kang-sw-archive/depth-cam-adv/reference/MCU/stm32f4-discovery-with-spi-pinout-wiring.png

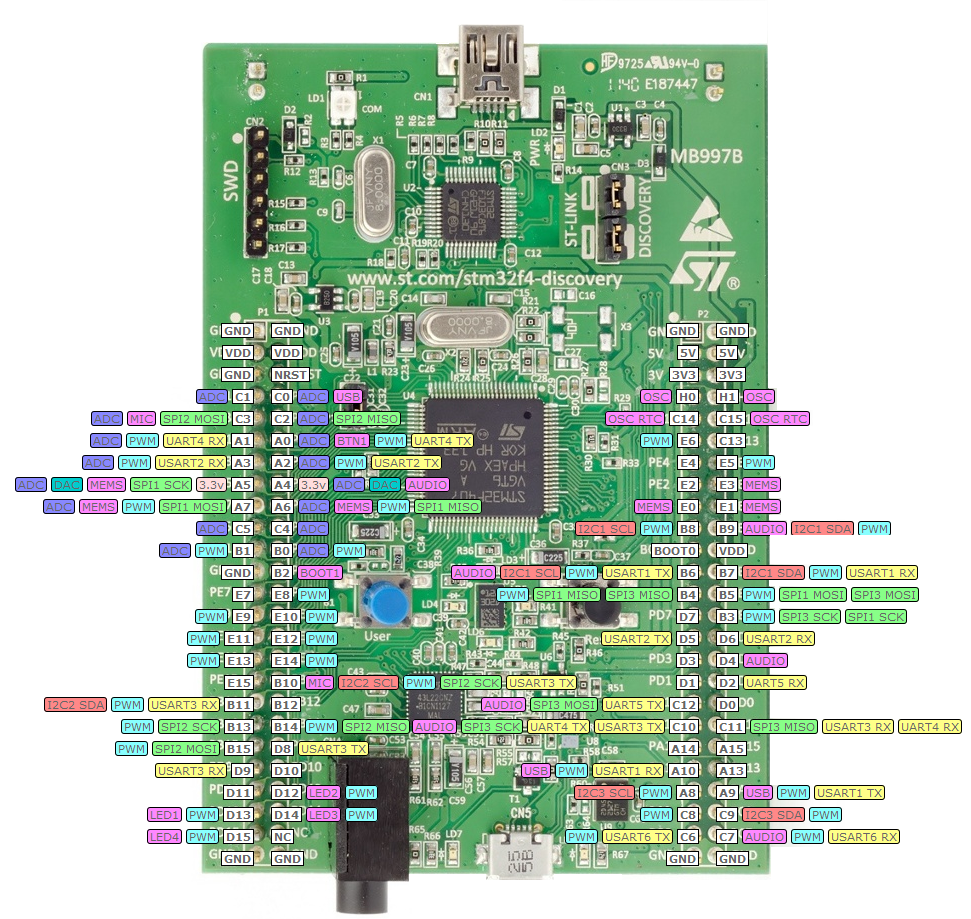
reference/MCU/stm32f4-discovery-with-spi-pinout-wiring.png
