kang-sw-archive/depth-cam-adv/samples/WIN_20200401_17_32_54_Pro.jpg

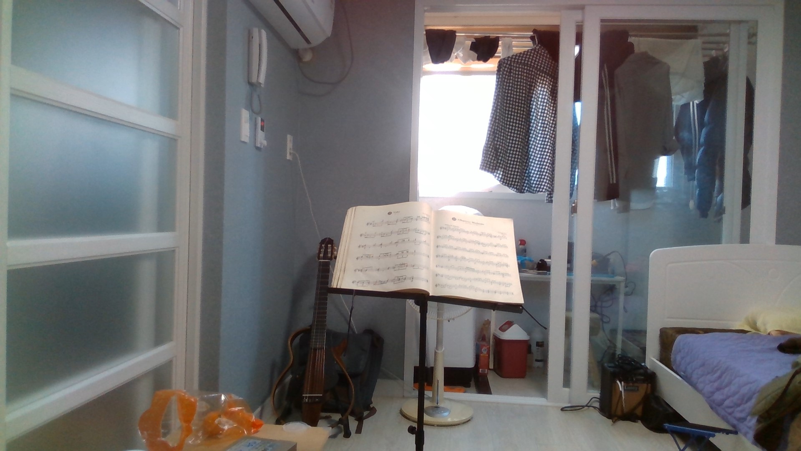
samples/WIN_20200401_17_32_54_Pro.jpg
