kang-sw-archive/depth-cam-adv/reference/Actuator/drv8825-mall.jpg

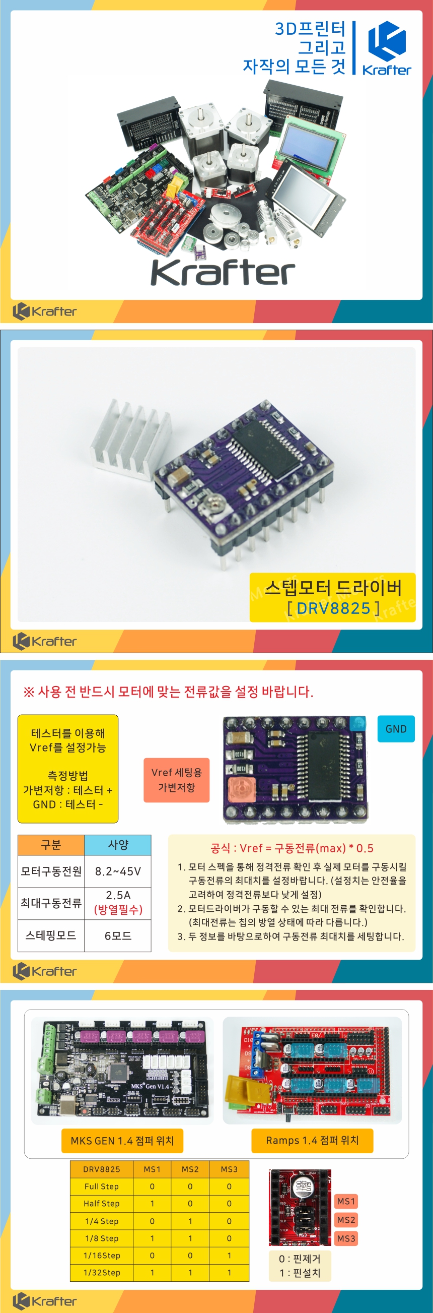
reference/Actuator/drv8825-mall.jpg
