kang-sw-archive/depth-cam-adv/reference/Actuator/DRV8825-REF.jpg

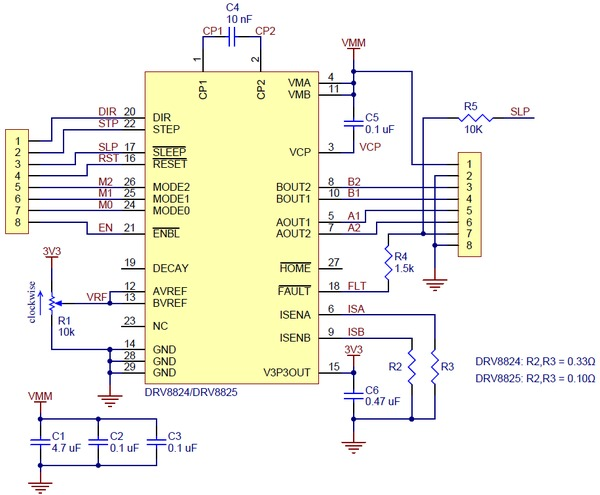
reference/Actuator/DRV8825-REF.jpg
