kang-sw-archive/depth-cam-adv/samples/case0-depth-grid.png

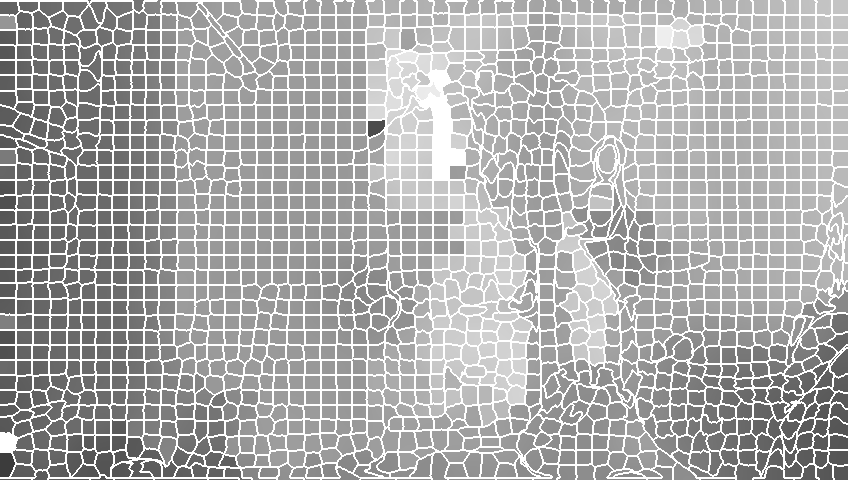
samples/case0-depth-grid.png
