kang-sw-archive/depth-cam-adv/samples/case0-rgb.png

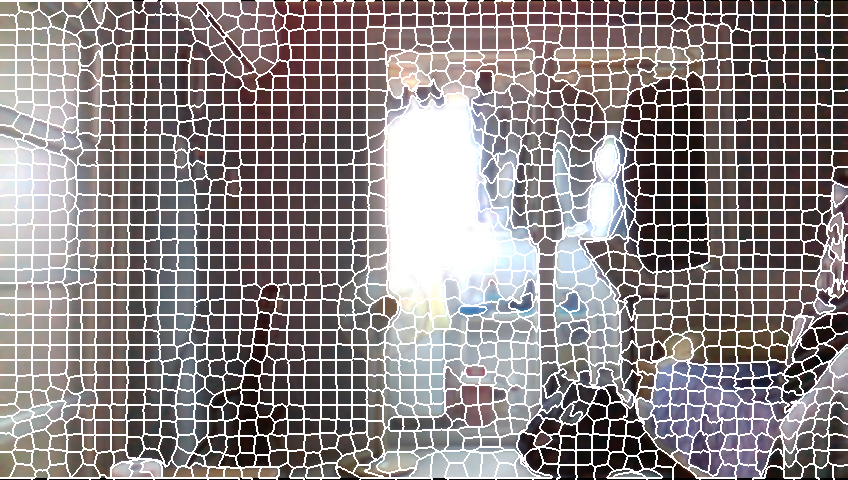
samples/case0-rgb.png
