kang-sw-archive/depth-cam-adv/samples/case1-rgb.png

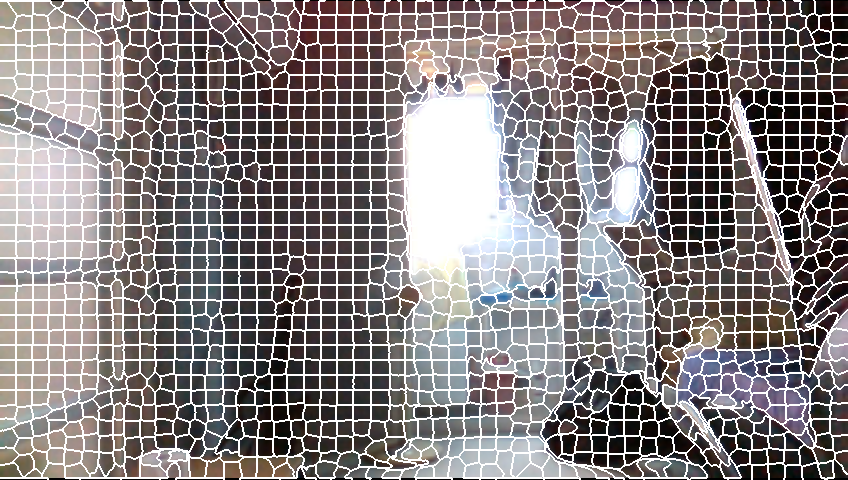
samples/case1-rgb.png
