kang-sw-archive/depth-cam-adv/samples/center_obj_book.jpg

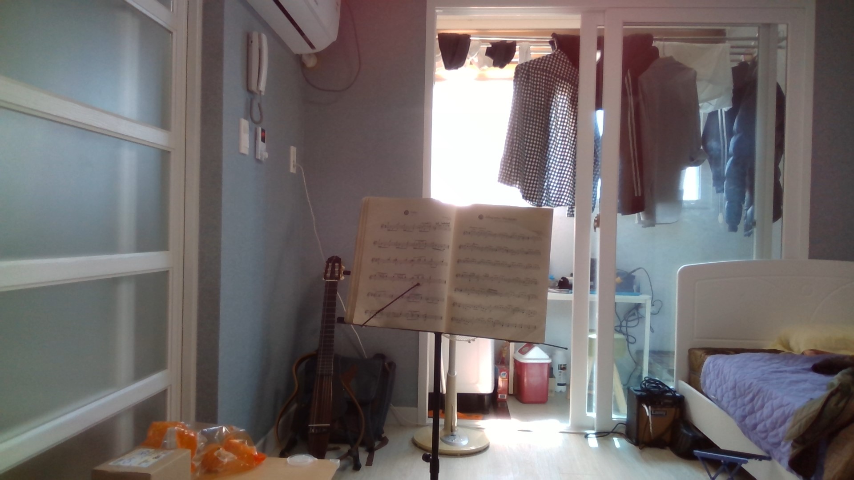
samples/center_obj_book.jpg
