kang-sw-archive/depth-cam-adv/samples/center_obj_box.jpg

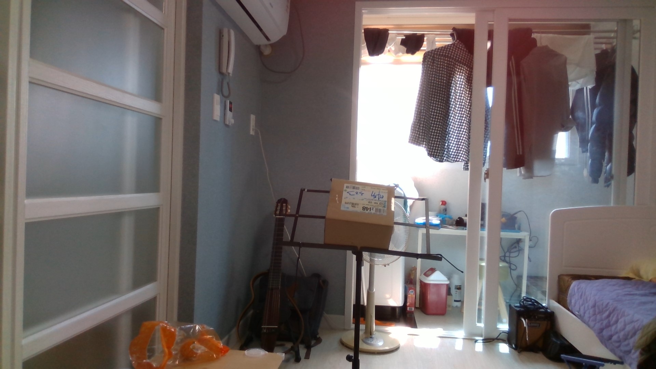
samples/center_obj_box.jpg
