kang-sw-archive/depth-cam-adv/samples/img.png

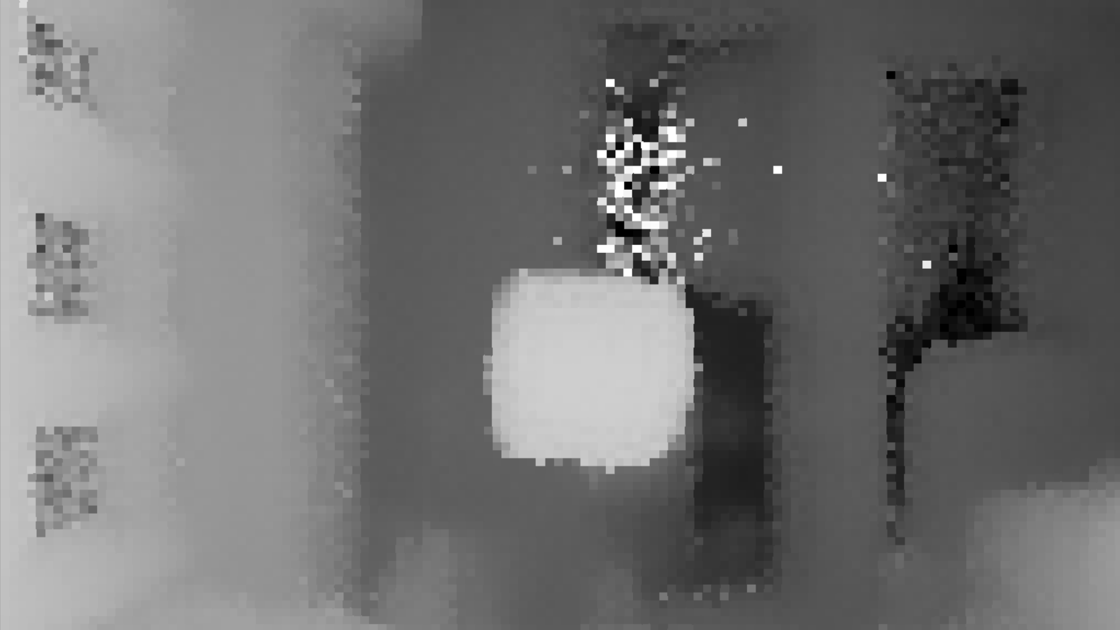
samples/img.png
