kang-sw-archive/depth-cam-adv/samples/rgb-2.png

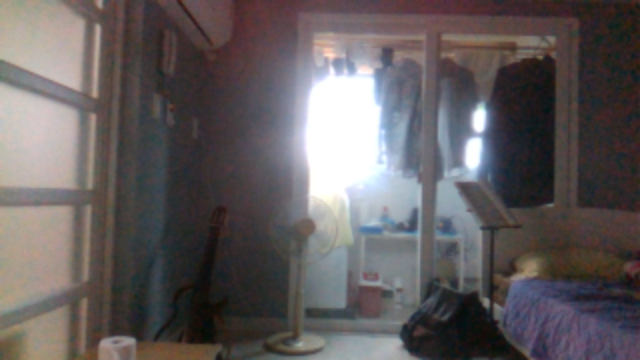
samples/rgb-2.png
