kang-sw-archive/depth-cam-adv/samples/vfov38-depth-9600smpl.png

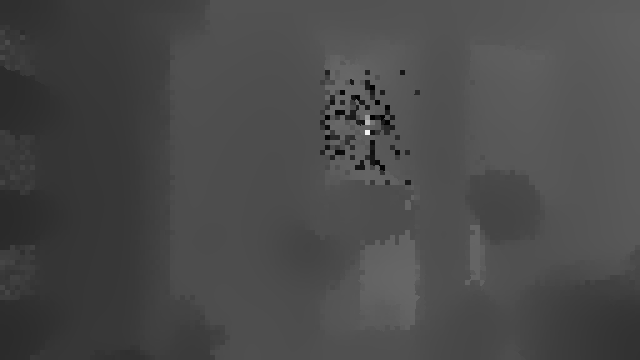
samples/vfov38-depth-9600smpl.png
