kang-sw-archive/depth-cam-adv/samples/vfov43-depth-9600pcs-2.png

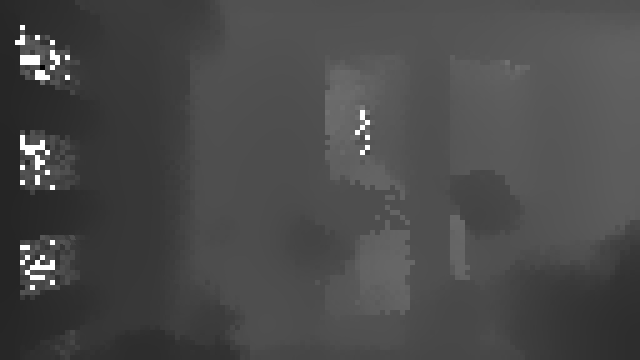
samples/vfov43-depth-9600pcs-2.png
