kang-sw-archive/depth-cam-adv/samples/vfov43-depth-9600smpl.png

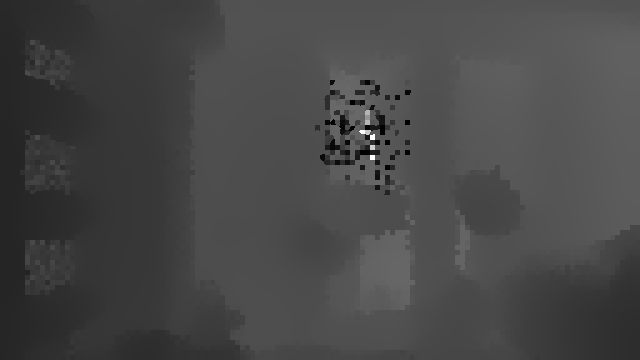
samples/vfov43-depth-9600smpl.png
