kang-sw-archive/depth-cam-adv/samples/vfov44-depth-6600pcs.png

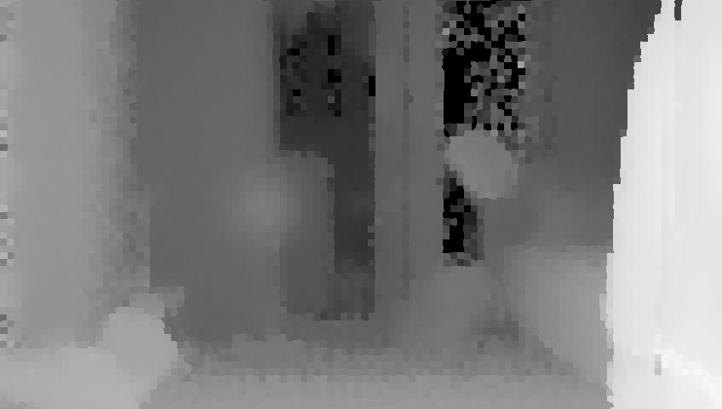
samples/vfov44-depth-6600pcs.png
