kang-sw-archive/depth-cam-adv/projects/tof-depth-map-gen-revision/TODO.md

# TODO

## Features (Lower is higher demand)
1. USB communication
   1. Data tranceiver protocol
2. PC driver application base
   1. Virtual COM Port detection
   2. Data transceiver protocol
   3. Logging / data flow watcher
3. ToF sensor driver
   1. ARGUS API hardware layer
      1. DMA SPI
      2. Timer
4. Motor interface
5. Ethernet module driver

## Done
