kang-sw-archive/depth-cam-adv/schematics/ARCHIVE/MEASURE_IF-v1.0.1/AFBR-S50_LEGACY_ART.pdf

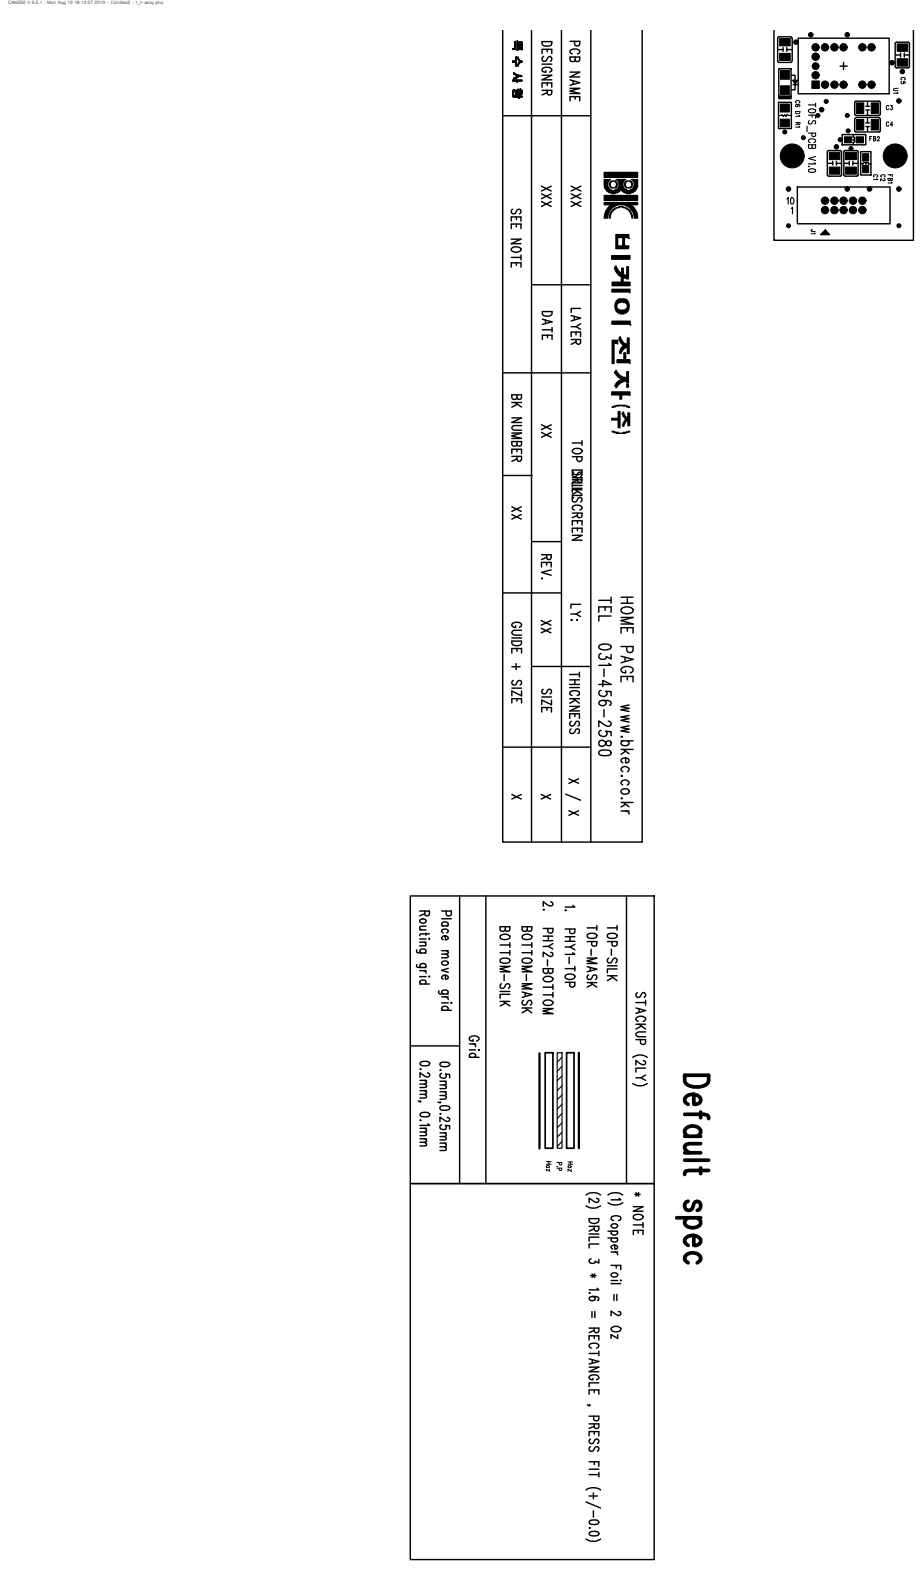
[picture p18: page 1]

CAM350 V 9.5.1 : Mon Aug 19 18:14:07 2019 - (Untitled) : 1_t-assy.pho

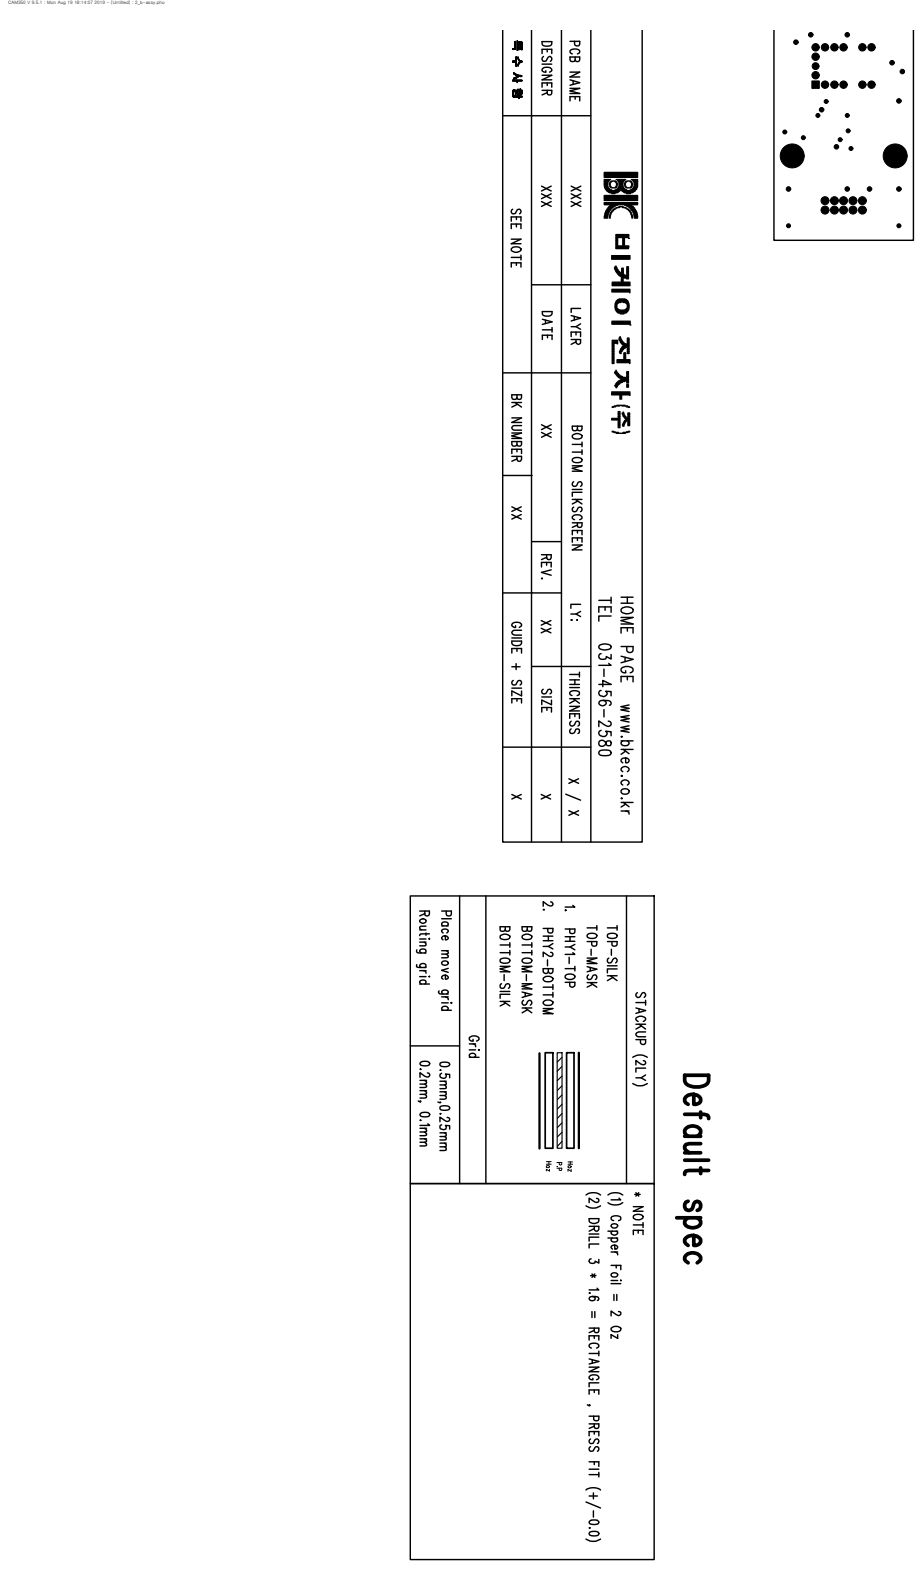
[picture p19: page 2]

CAM350 V 9.5.1 : Mon Aug 19 18:14:07 2019 - (Untitled) : 2_b-assy.pho

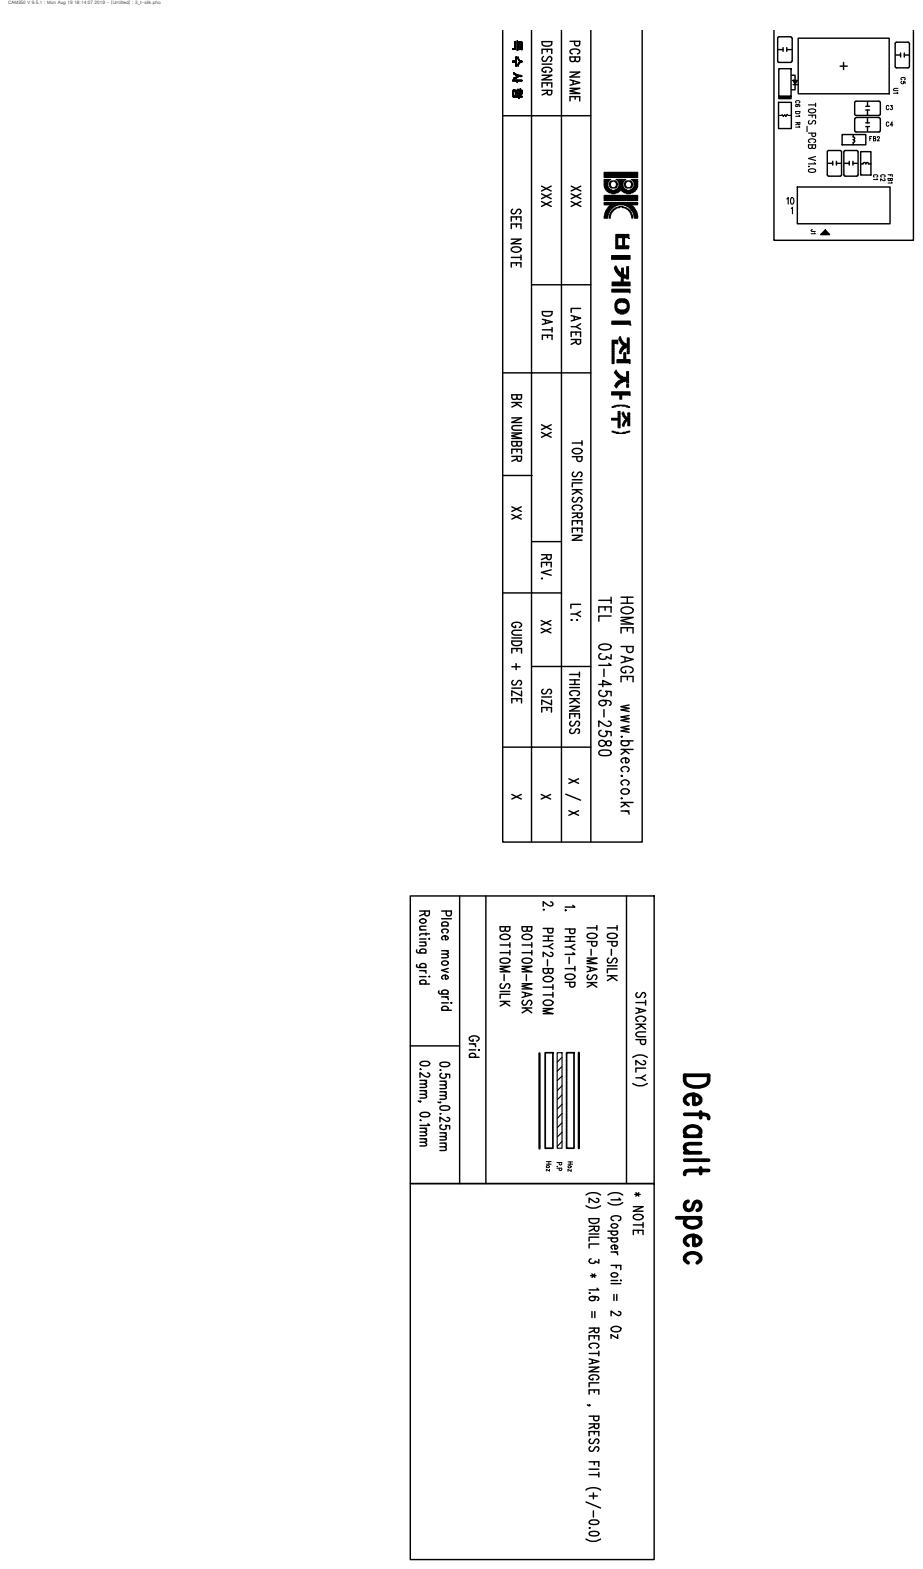
[picture p20: page 3]

CAM350 V 9.5.1 : Mon Aug 19 18:14:07 2019 - (Untitled) : 3_t-silk.pho

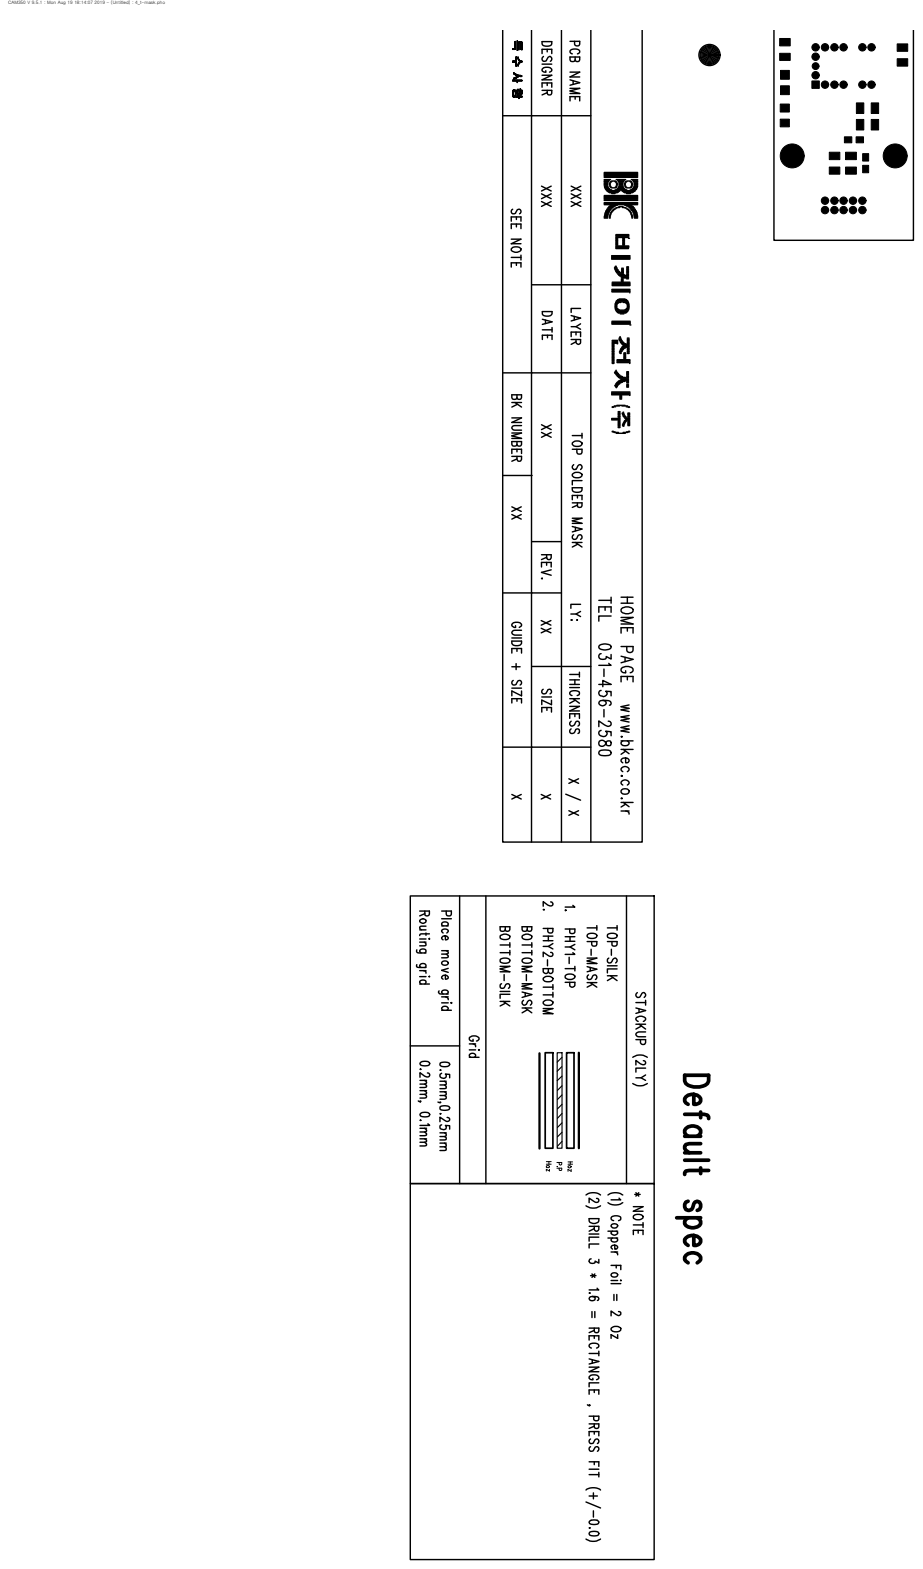
[picture p21: page 4]

CAM350 V 9.5.1 : Mon Aug 19 18:14:07 2019 - (Untitled) : 4_t-mask.pho

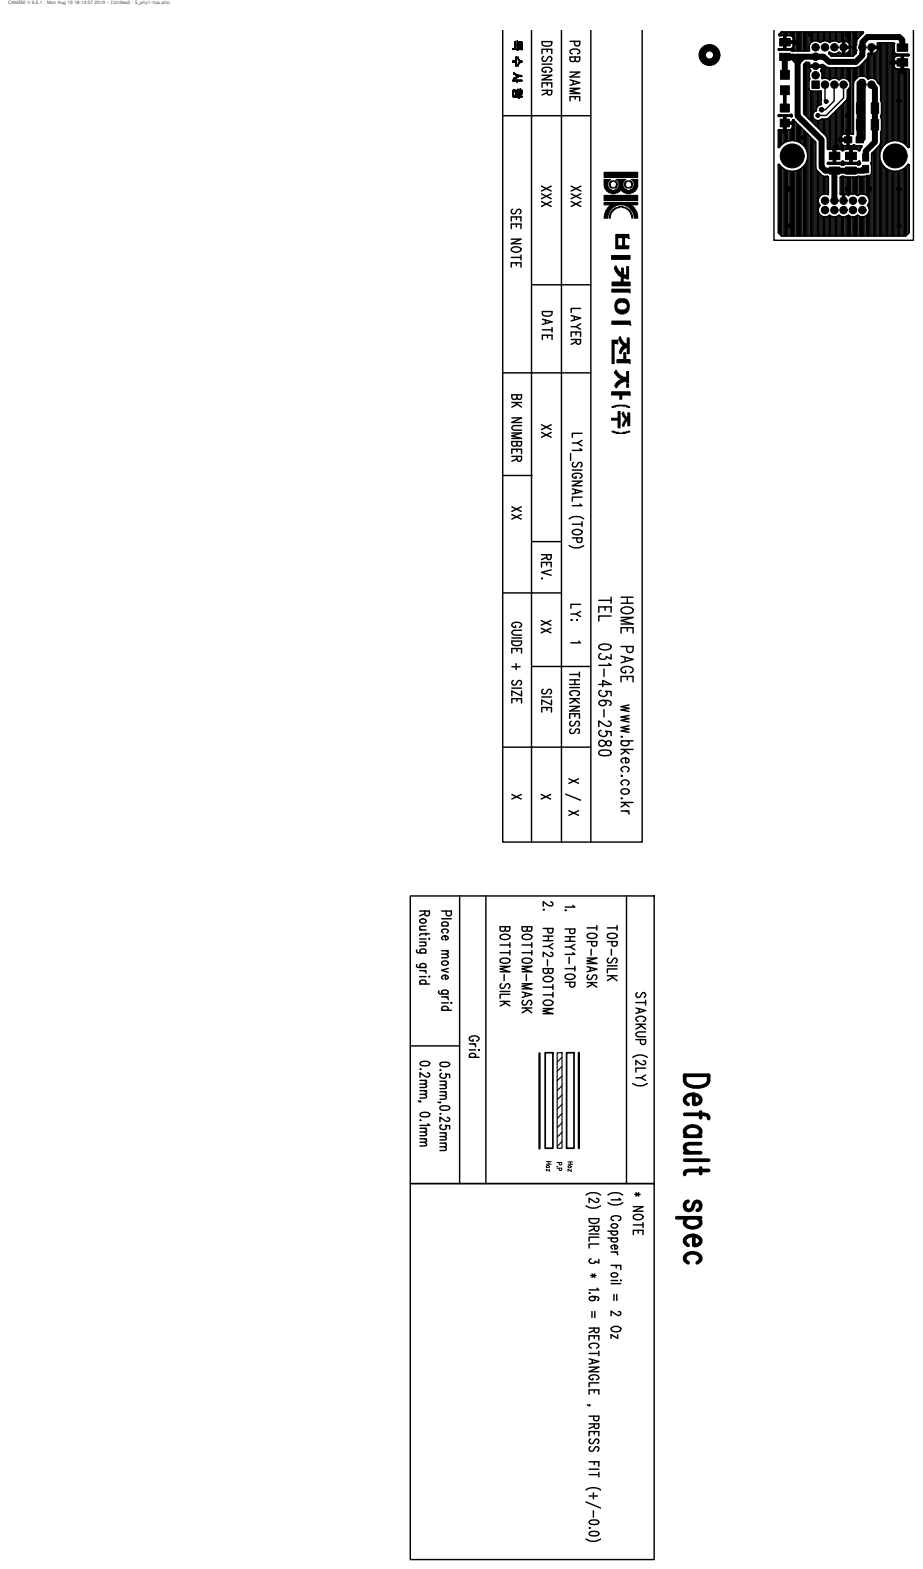
[picture p22: page 5]

CAM350 V 9.5.1 : Mon Aug 19 18:14:07 2019 - (Untitled) : 5_phy1-top.pho

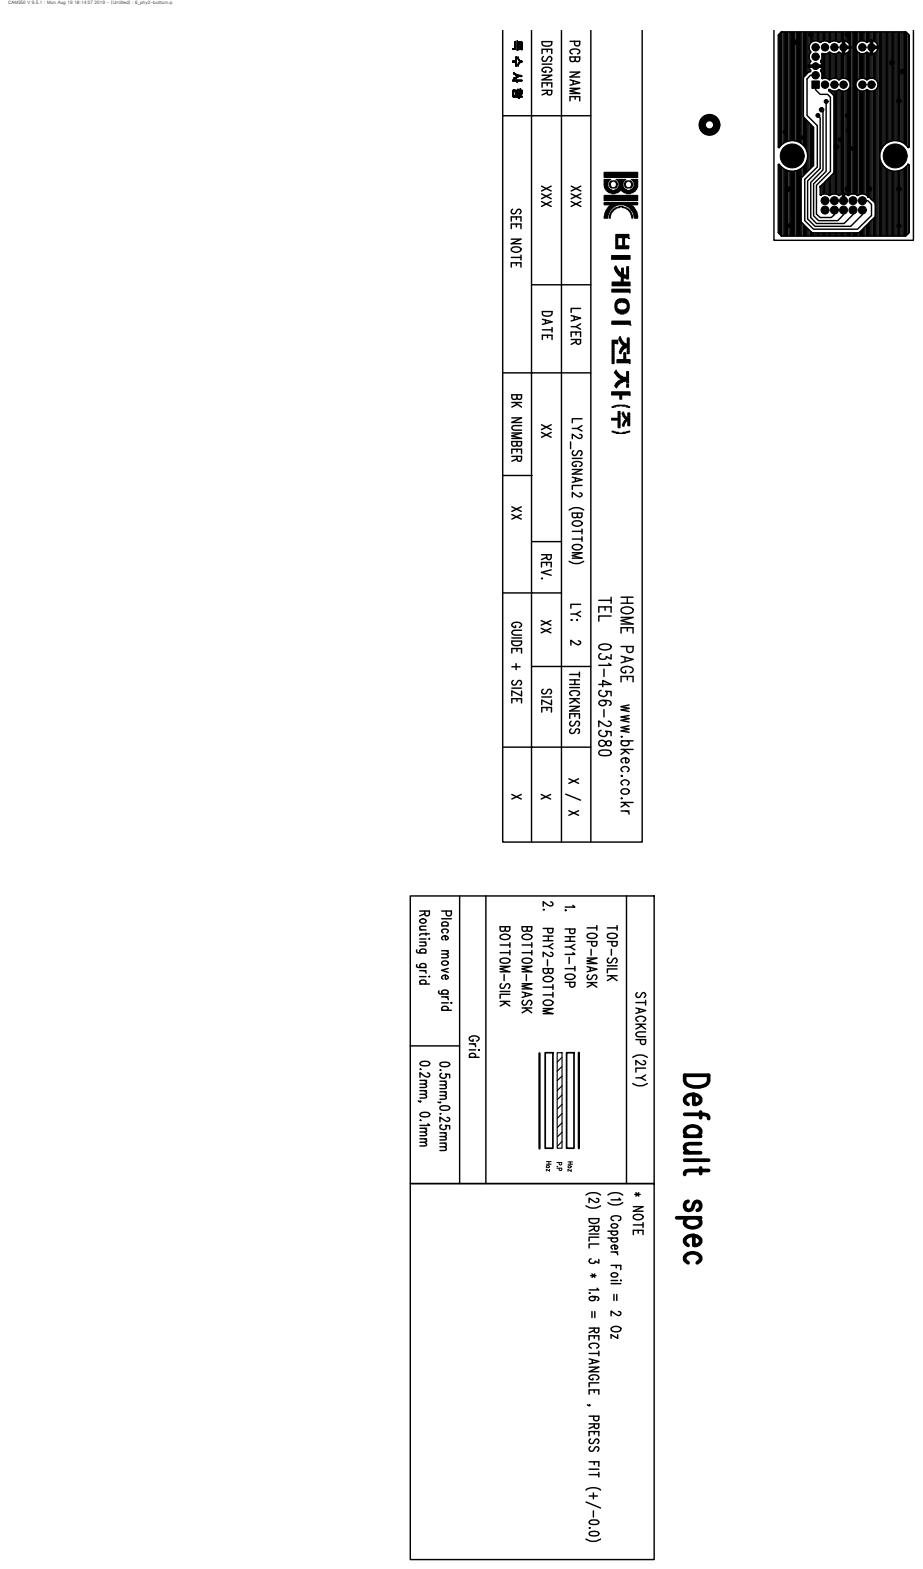
[picture p23: page 6]

CAM350 V 9.5.1 : Mon Aug 19 18:14:07 2019 - (Untitled) : 6_phy2-bottom.p

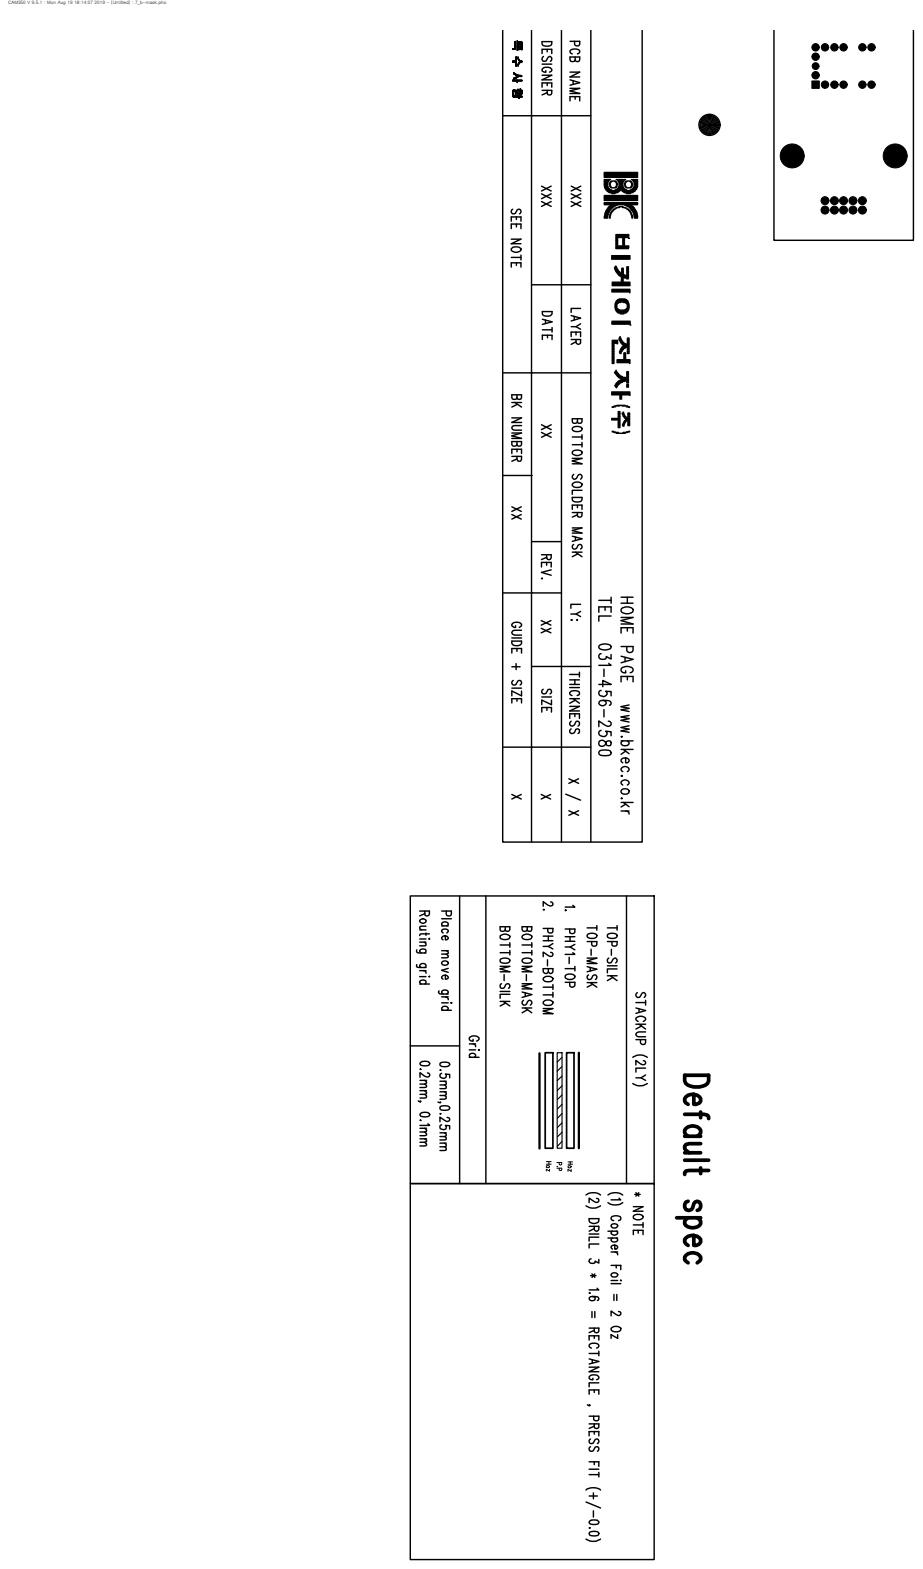
[picture p24: page 7]

CAM350 V 9.5.1 : Mon Aug 19 18:14:07 2019 - (Untitled) : 7_b-mask.pho

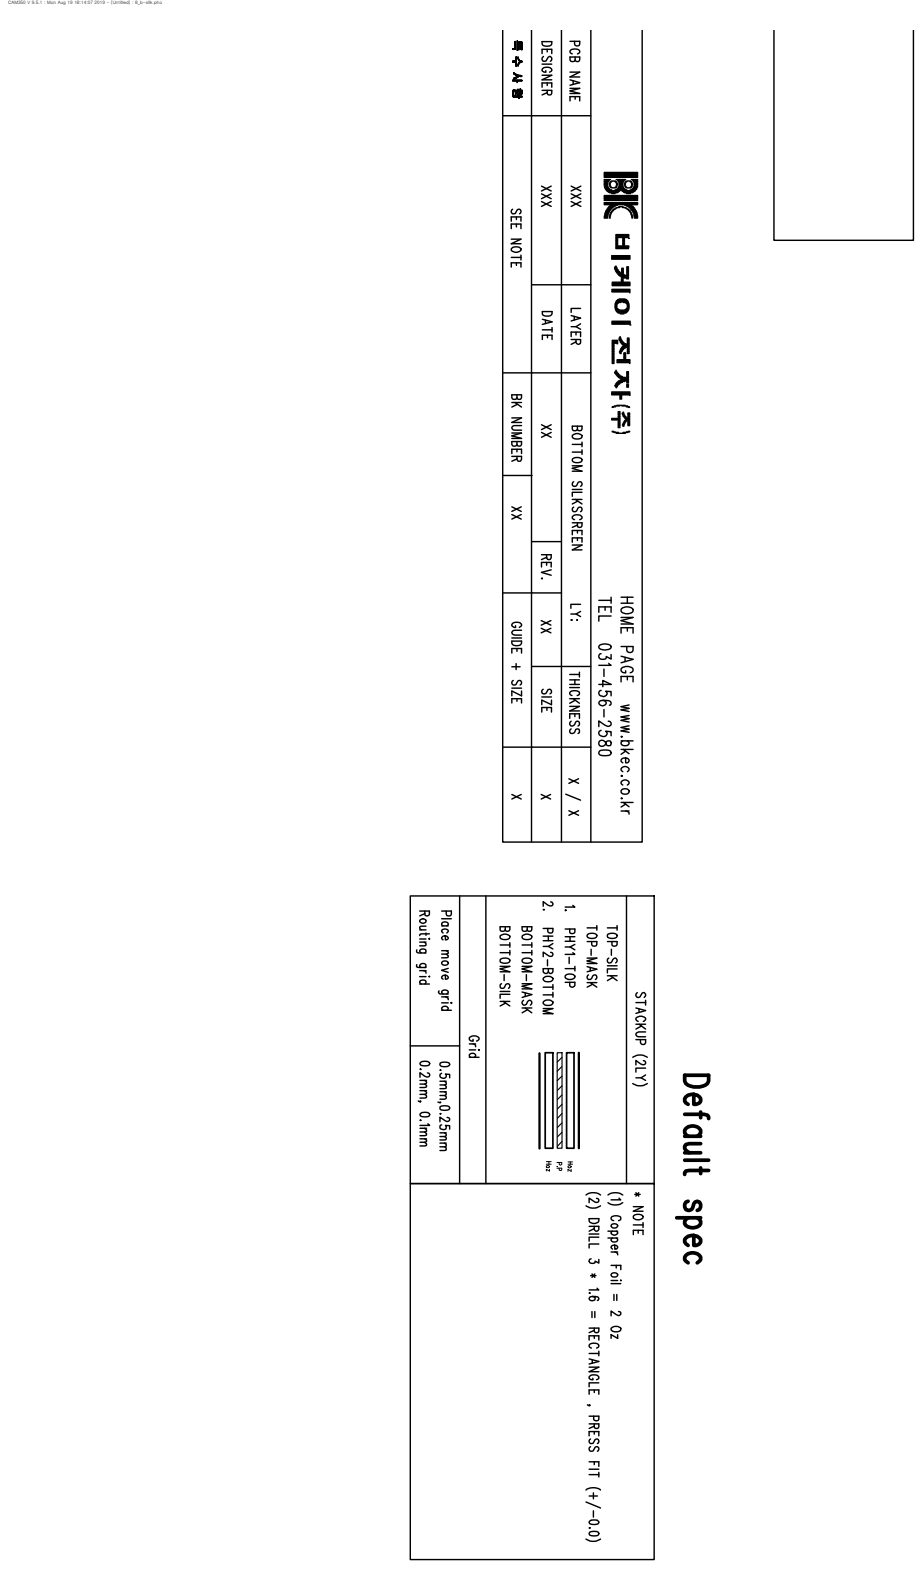
[picture p25: page 8]

CAM350 V 9.5.1 : Mon Aug 19 18:14:07 2019 - (Untitled) : 8_b-silk.pho
