kang-sw-archive/depth-cam-adv/schematics/ARCHIVE/MEASURE_IF-v1.0.1/AFBR-S50_LEGACY_SCH.pdf

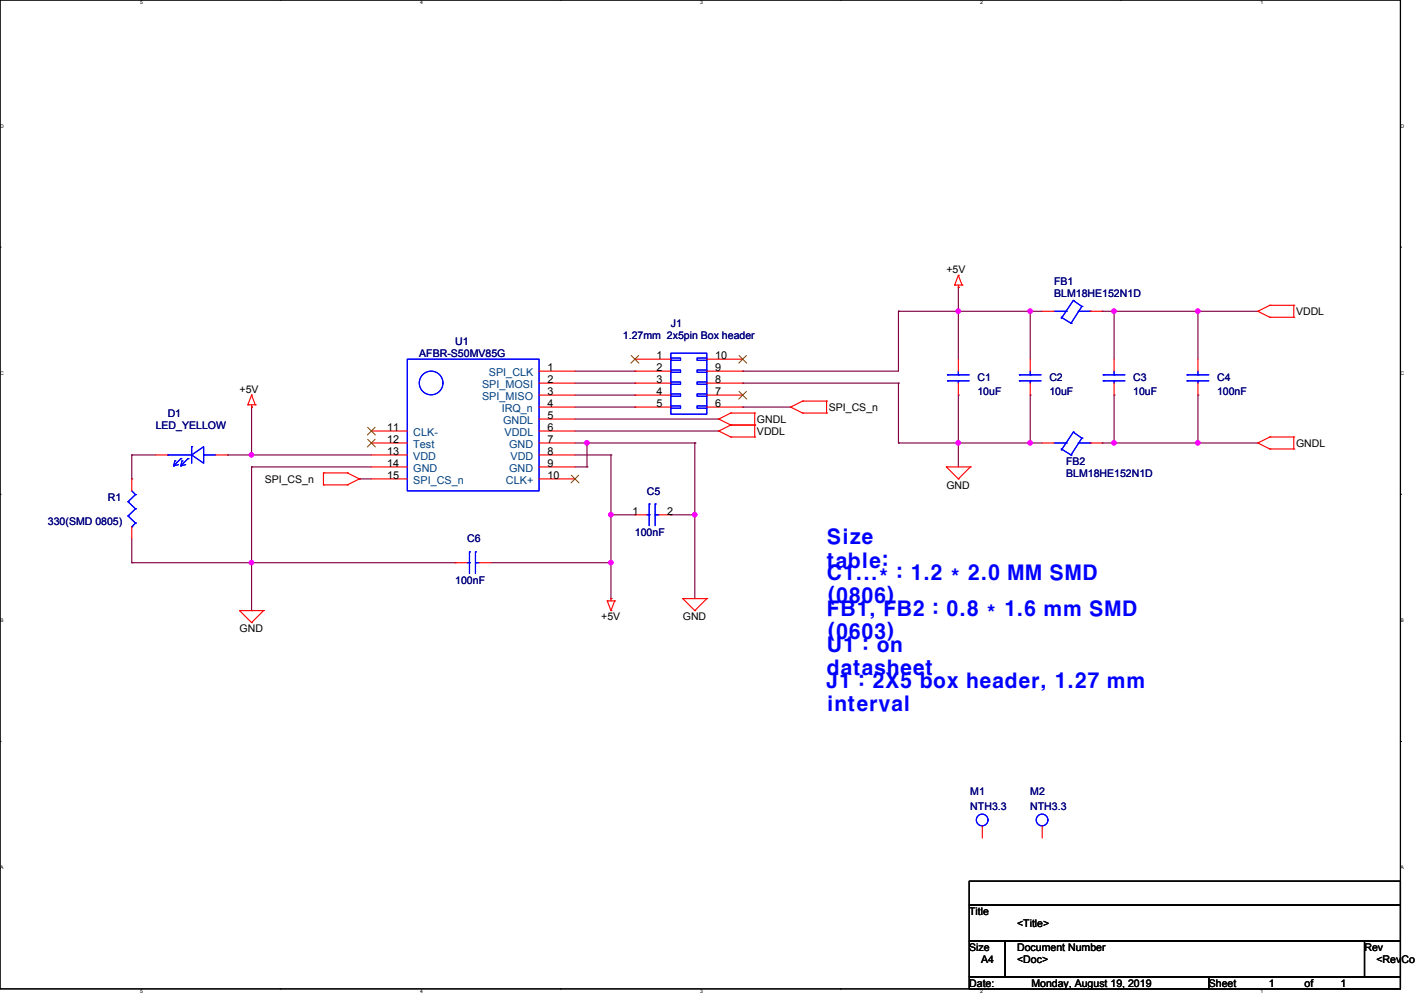
[picture p26: page 1]
