kang-sw-archive/depth-cam-adv/schematics/MEASURE_IF/MEASURE_IF.kicad_pcb

## KiCad design schematics/MEASURE_IF/MEASURE_IF.kicad_pcb (2020-02-13)

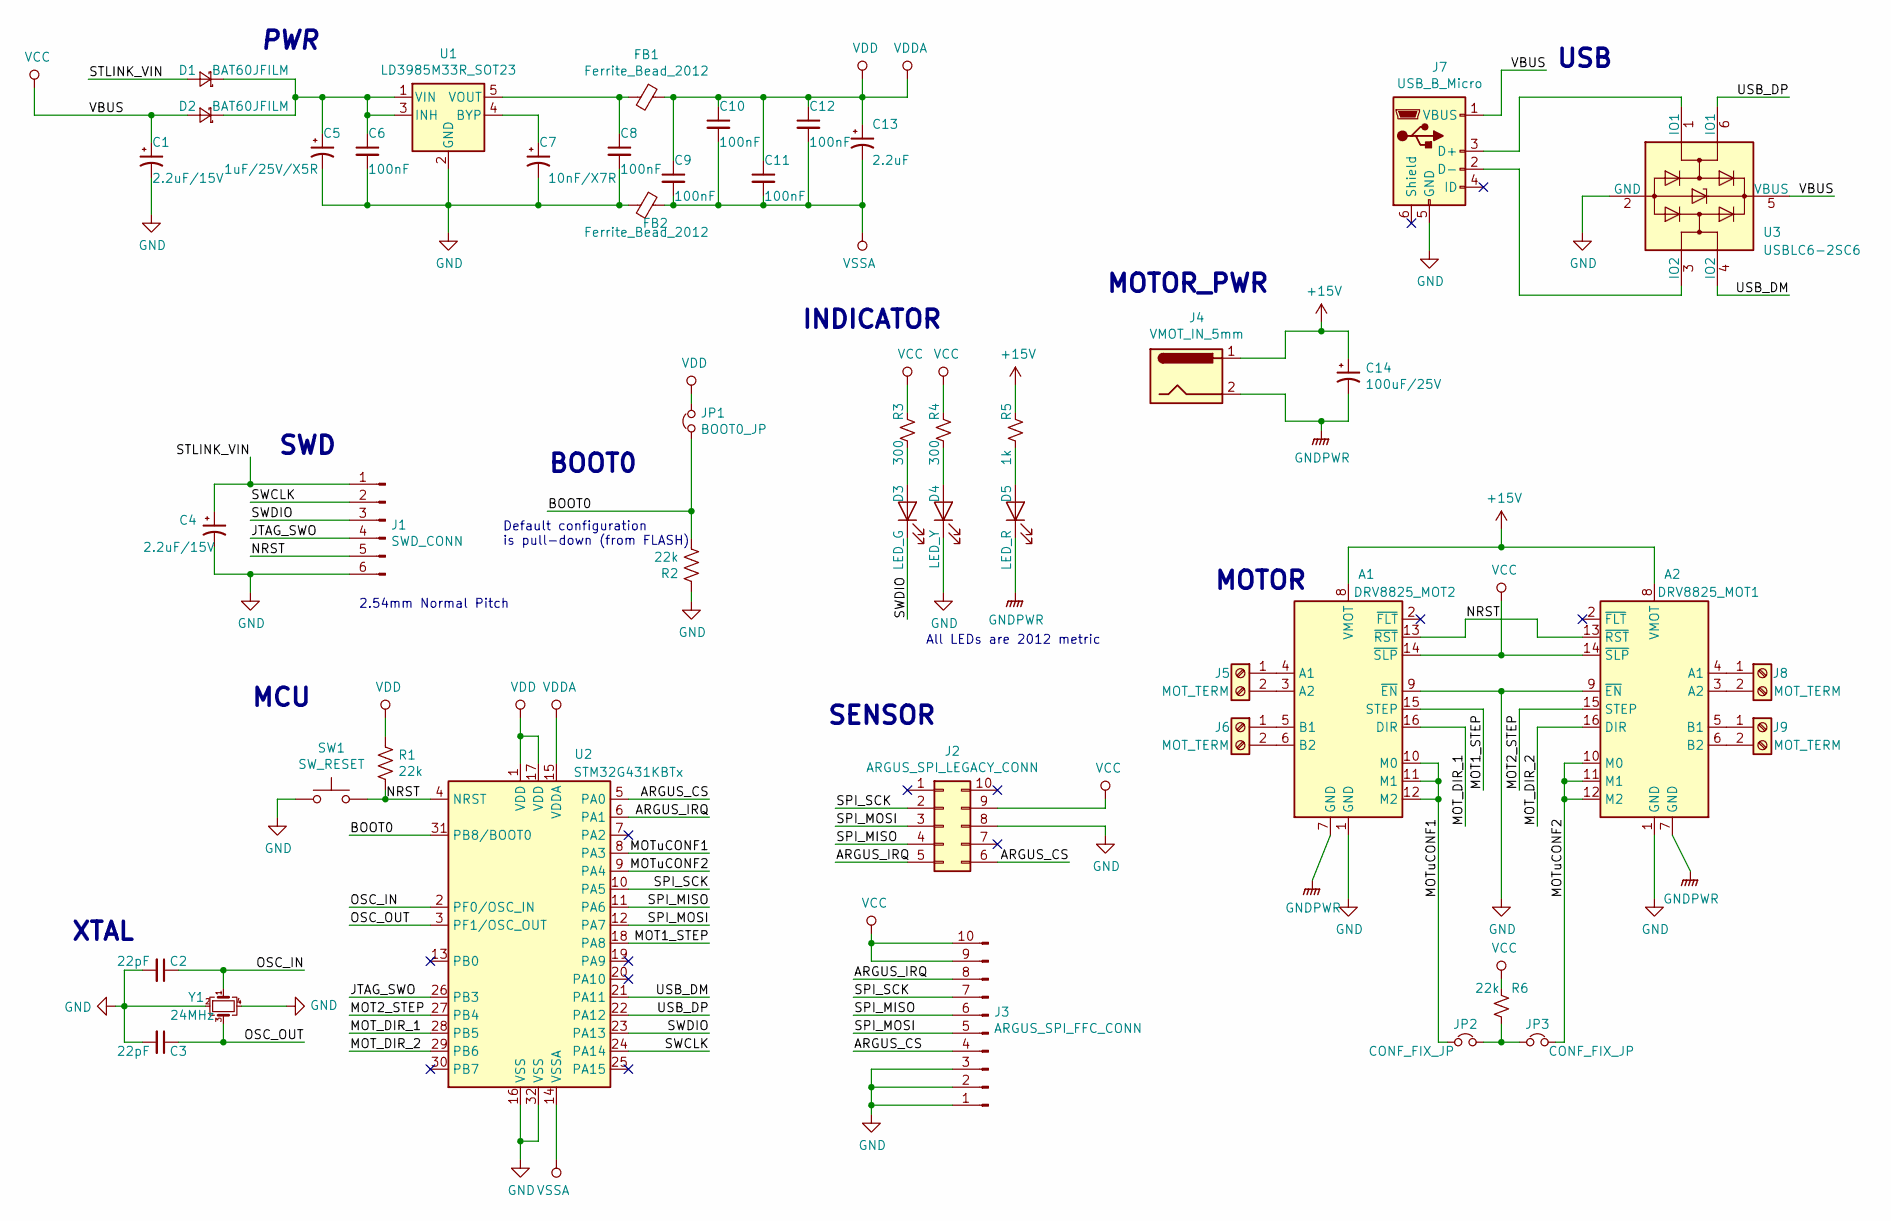
[picture p27: schematic MEASURE_IF.sch, Depscan Interface Board]

Parts:
A1: DRV8825_MOT2; Pololu_Breakout-16_15.2x20.3mm
A2: DRV8825_MOT1; Pololu_Breakout-16_15.2x20.3mm
C1, C4: 2.2uF/15V; C_0805_2012Metric_Pad1.15x1.40mm_HandSolder
C2, C3: 22pF; C_0805_2012Metric_Pad1.15x1.40mm_HandSolder
C5: 1uF/25V/X5R; C_0805_2012Metric_Pad1.15x1.40mm_HandSolder
C6, C8, C9, C10, C11, C12: 100nF; C_0805_2012Metric_Pad1.15x1.40mm_HandSolder
C7: 10nF/X7R; C_0805_2012Metric_Pad1.15x1.40mm_HandSolder
C13: 2.2uF; C_0805_2012Metric_Pad1.15x1.40mm_HandSolder
C14: 100uF/25V; CP_Elec_6.3x5.2
D1, D2: BAT60JFILM; D_SOD-323
D3: LED_G; LED_0805_2012Metric
D4: LED_Y; LED_0805_2012Metric
D5: LED_R; LED_0805_2012Metric
FB1, FB2: Ferrite_Bead_2012; L_0805_2012Metric_Pad1.15x1.40mm_HandSolder
J1: SWD_CONN; PinHeader_2x03_P2.54mm_Vertical
J2: ARGUS_SPI_LEGACY_CONN; CONN02x05CLOCKWISE
J3: ARGUS_SPI_FFC_CONN; Hirose_FH12-10S-0.5SH_1x10-1MP_P0.50mm_Horizontal
J4: VMOT_IN_5mm; BarrelJack_Horizontal
J5, J6, J8, J9: MOT_TERM; TerminalBlock_bornier-2_P5.08mm
J7: USB_B_Micro; USB_Micro-B_Molex_47346-0001
JP1: BOOT0_JP; PinHeader_1x02_P2.54mm_Vertical
JP2, JP3: CONF_FIX_JP; SolderJumper-2_P1.3mm_Open_TrianglePad1.0x1.5mm
R1, R2, R6: 22k; R_0805_2012Metric_Pad1.15x1.40mm_HandSolder
R3, R4: 300; R_0805_2012Metric_Pad1.15x1.40mm_HandSolder
R5: 1k; R_0805_2012Metric_Pad1.15x1.40mm_HandSolder
SW1: SW_RESET; SW_SMD_TS1107
U1: LD3985M33R_SOT23; SOT-23-5
U2: STM32G431KBTx; LQFP-32_7x7mm_P0.8mm
U3: USBLC6-2SC6; SOT-23-6
Y1: 24MHz; Crystal_SMD_SeikoEpson_FA238V-4Pin_3.2x2.5mm_HandSoldering

Connections:
+15V: A1.8 (VMOT), A2.8 (VMOT), C14.1, J4.1, R5.1
/ARGUS_CS: J2.6, J3.4, U2.5 (PA0)
/ARGUS_IRQ: J2.5, J3.8, U2.6 (PA1)
/BOOT0: JP1.1, R2.2, U2.31 (PB8/BOOT0)
/JTAG_SWO: J1.4, U2.26 (PB3)
/MOT1_STEP: A1.15 (STEP), U2.18 (PA8)
/MOT2_STEP: A2.15 (STEP), U2.27 (PB4)
/MOT_DIR_1: A1.16 (DIR), U2.28 (PB5)
/MOT_DIR_2: A2.16 (DIR), U2.29 (PB6)
/MOTuCONF1: A1.10 (M0), A1.11 (M1), A1.12 (M2), JP2.1, U2.8 (PA3)
/MOTuCONF2: A2.10 (M0), A2.11 (M1), A2.12 (M2), JP3.2, U2.9 (PA4)
/NRST: A1.13 (~RST), A2.13 (~RST), J1.5, R1.2, SW1.2, U2.4 (NRST)
/OSC_IN: C2.1, U2.2 (PF0/OSC_IN), Y1.1
/OSC_OUT: C3.1, U2.3 (PF1/OSC_OUT), Y1.3
/SPI_MISO: J2.4, J3.6, U2.11 (PA6)
/SPI_MOSI: J2.3, J3.5, U2.12 (PA7)
/SPI_SCK: J2.2, J3.7, U2.10 (PA5)
/STLINK_VIN: C4.1, D1.2 (A), J1.1
/SWCLK: J1.2, U2.24 (PA14)
/SWDIO: D3.1 (K), J1.3, U2.23 (PA13)
/USB_DM: U2.21 (PA11), U3.4 (IO2)
/USB_DP: U2.22 (PA12), U3.6 (IO1)
GND: A1.1 (GND), A1.9 (~EN), A2.1 (GND), A2.9 (~EN), C1.2, C2.2, C3.2, C4.2, C5.2, C6.2, C7.2, C8.2, D4.1 (K), FB2.2, J1.6, J2.8, J3.1, J3.2, J3.3, J7.5 (GND), R2.1, SW1.1, U1.2 (GND), U2.16 (VSS), U2.32 (VSS), U3.2 (GND), Y1.2, Y1.4
GNDPWR: A1.7 (GND), A2.7 (GND), C14.2, D5.1 (K), J4.2
unnamed: A1.3 (A2), J5.2
unnamed: A1.4 (A1), J5.1
unnamed: A1.5 (B1), J6.1
unnamed: A1.6 (B2), J6.2
unnamed: A2.3 (A2), J8.2
unnamed: A2.4 (A1), J8.1
unnamed: A2.5 (B1), J9.1
unnamed: A2.6 (B2), J9.2
unnamed: C5.1, C6.1, D1.1 (K), D2.1 (K), U1.1 (VIN), U1.3 (INH)
unnamed: C7.1, U1.4 (BYP)
unnamed: C8.1, FB1.2, U1.5 (VOUT)
unnamed: D3.2 (A), R3.2
unnamed: D4.2 (A), R4.2
unnamed: D5.2 (A), R5.2
unnamed: J7.2 (D-), U3.3 (IO2)
unnamed: J7.3 (D+), U3.1 (IO1)
unnamed: JP2.2, JP3.1, R6.2
VCC: A1.14 (~SLP), A2.14 (~SLP), C1.1, D2.2 (A), J2.9, J3.9, J3.10, J7.1 (VBUS), R3.1, R4.1, R6.1, U3.5 (VBUS)
VDD: C9.1, C10.1, C11.1, C12.1, C13.1, FB1.1, JP1.2, R1.1, U2.1 (VDD), U2.15 (VDDA), U2.17 (VDD)
VSSA: C9.2, C10.2, C11.2, C12.2, C13.2, FB2.1, U2.14 (VSSA)

Notes on the sheet:
PWR
USB
MCU
MOTOR
SWD
XTAL
2.54mm Normal Pitch
SENSOR
MOTOR_PWR
INDICATOR
All LEDs are 2012 metric
BOOT0
Default configuration is pull-down (from FLASH)

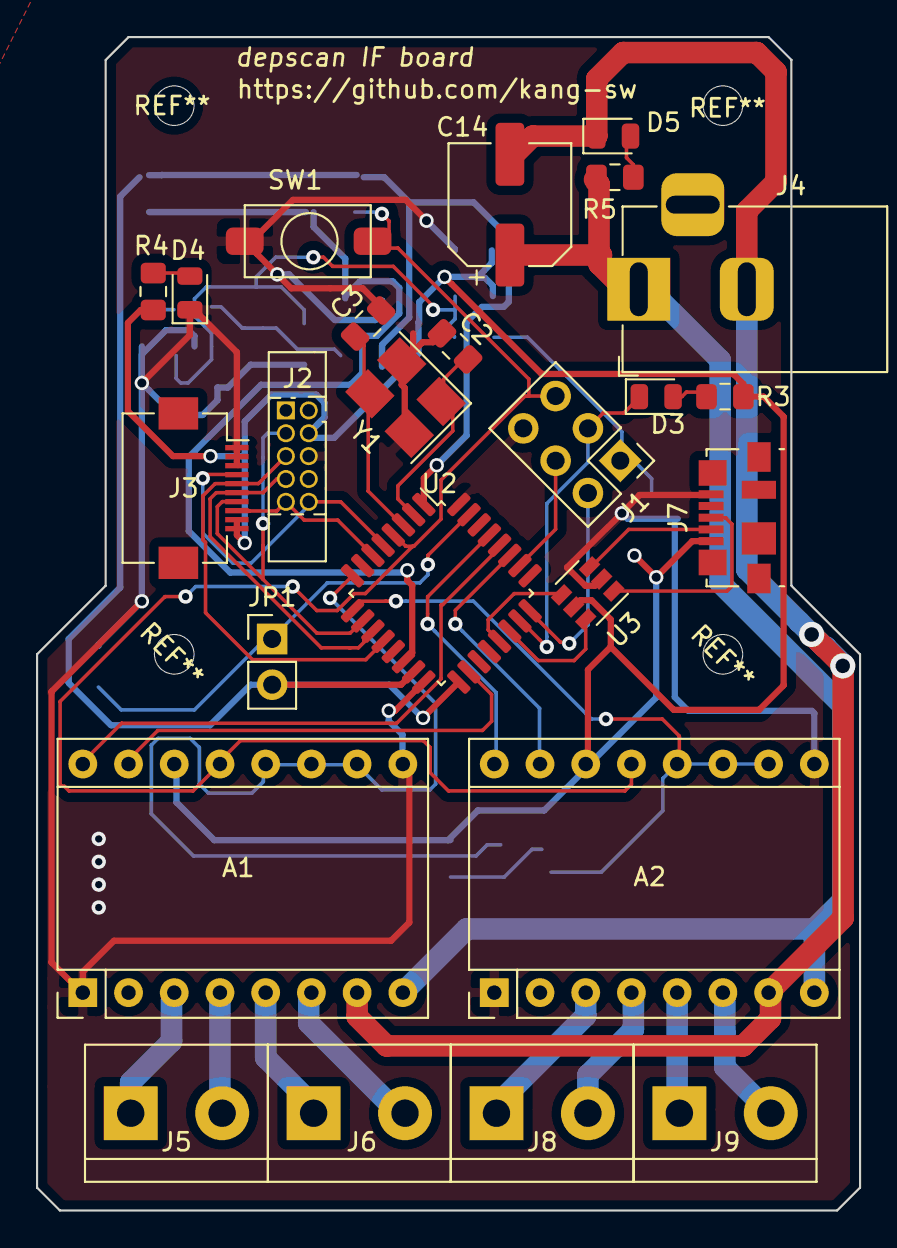
[picture p28: board MEASURE_IF.kicad_pcb from above]

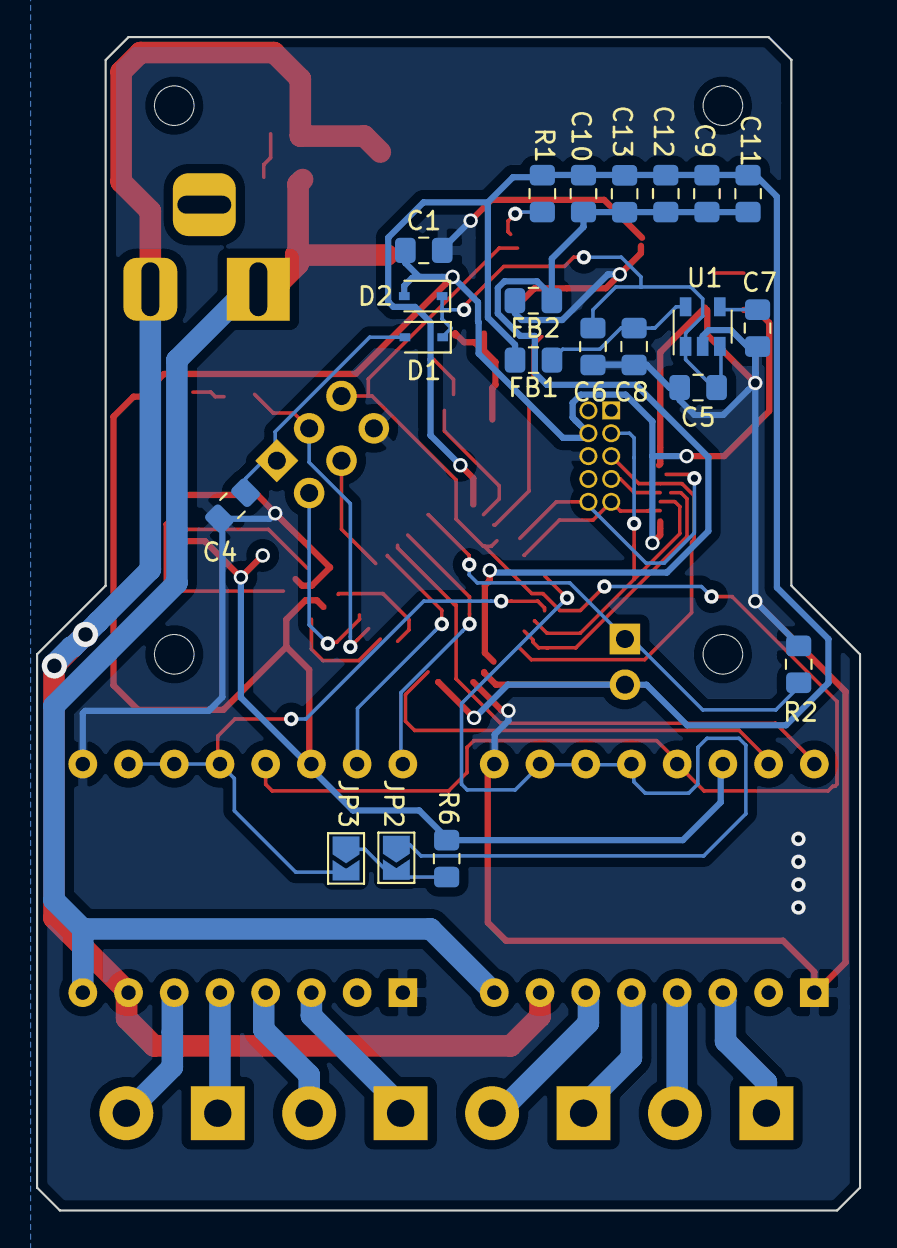
[picture p29: board MEASURE_IF.kicad_pcb from below]

Board: 2 copper layers, 45.7 x 65.2 mm, 46 parts (21 on the bottom side), 44 nets.
