kang-sw-archive/depth-cam-adv/projects/tof-depth-map-gen-revision/tof-depth-map-gen-revision.ioc

Mcu.UserName=STM32F401VCTx
PA10.Signal=GPIO_Output
PA11.Signal=USB_OTG_FS_DM
PA12.Signal=USB_OTG_FS_DP
PA5.Signal=SPI1_SCK
PA6.Signal=SPI1_MISO
PA7.Signal=SPI1_MOSI
PA8.Signal=S_TIM1_CH1
PB10.Signal=GPIO_Output
PB4.Signal=S_TIM3_CH1
PB8.Signal=GPIO_Output
PB9.Signal=GPIO_Output
PC0.Signal=GPIO_Output
PC1.Signal=GPXTI1
PC2.Signal=GPIO_Output
PC6.Signal=GPIO_Input
PC7.Signal=GPIO_Input
PE8.Signal=GPIO_Input
