kang-sw-archive/depth-cam-adv/projects/depscan-firmware-rtos/Inc/main.h

#define ARGUS_CS_Pin GPIO_PIN_0
#define ARGUS_CS_GPIO_Port GPIOC
#define ARGUS_IRQ_Pin GPIO_PIN_1
#define ARGUS_IRQ_GPIO_Port GPIOC
#define ARGUS_IRQ_EXTI_IRQn EXTI1_IRQn
#define MOT_STEP1_Pin GPIO_PIN_8
#define MOT_STEP1_GPIO_Port GPIOA
#define MOT_STEP2_Pin GPIO_PIN_4
#define MOT_STEP2_GPIO_Port GPIOB
#define MOT_DIR_1_Pin GPIO_PIN_8
#define MOT_DIR_1_GPIO_Port GPIOB
#define MOT_DIR_2_Pin GPIO_PIN_9
#define MOT_DIR_2_GPIO_Port GPIOB
