kang-sw-archive/depth-cam-adv/projects/depscan-firmware-rtos/Src-Usr/app-proc.cpp

#include "app.h"
#include "defs.h"
#include "protocol.h"
#include "rw.h"
#include <alloca.h>
#include <semphr.h>
#include <stdarg.h>
#include <stdio.h>
#include <stdlib.h>
#include <string.h>
#include <uEmbedded-pp/utility.hxx>
#include <uEmbedded/uassert.h>
/////////////////////////////////////////////////////////////////////////////
// Host IO communication handler
//
//

/////////////////////////////////////////////////////////////////////////////
// Utilities

// Command procedure
static void stringCmdHandler( char* str, size_t len );
static void binaryCmdHandler( char* data, size_t len );
// Token parser
static int stringToTokens( char* str, char* argv[], size_t argv_len );

// Flush buffered data to host
static char          s_hostTrBuf[HOST_TRANSFER_BUFFER_SIZE];
static size_t        s_hostTrBufHead = 0;
static volatile int  s_writingTask   = 0;
static volatile bool s_bFlushing     = 0;
static void          apndToHostBuf( void const* d, size_t len );
static void          flushTransmitData();

// Read host connection for requested byte length.
// @returns false when failed to receive data, with given timeout.
static bool readHostConn( void* dst, size_t len );

/////////////////////////////////////////////////////////////////////////////
// Primary Procedure
extern "C" _Noreturn void AppProc_HostIO( void* nouse_ )
{
    packetinfo_t packet;

    for ( ;; ) {
        // Check if read data has valid protocol.
        if ( readHostConn( &packet, PACKET_SIZE ) == false )
            continue;

        // Check packet validity
        // If any data was delivered in bad condition, it'll consume all pending bytes.
        if ( PACKET_IS_PACKET( packet ) == false )
            continue;

        // Should be aware of maximum stack depth!
        // Packet size must be less than 2kByte at once
        // Allocate packet receive memory using VLA
        auto len = PACKET_LENGTH( packet );
        char buf[len + 1];
        if ( readHostConn( buf, len ) == false )
            continue;

        // Call command procedure
        ( PACKET_IS_STR( packet ) ? stringCmdHandler : binaryCmdHandler )( buf, len );
    }
}

/////////////////////////////////////////////////////////////////////////////
// Global function defs
void API_SendHostBinary( void const* data, size_t len )
{
    packetinfo_t packet = PACKET_MAKE( false, len );
    apndToHostBuf( &packet, sizeof packet );
    apndToHostBuf( data, len );
}

void API_SendHostString( void const* data, size_t len )
{
    packetinfo_t packet = PACKET_MAKE( true, len );
    apndToHostBuf( &packet, sizeof packet );
    apndToHostBuf( data, len );
}

void API_SendHostRaw( void const* data, size_t len )
{
    apndToHostBuf( data, len );
}

extern "C" void API_Logf( char const* fmt, ... )
{
    va_list vp;
    va_list vp2;
    va_start( vp, fmt );
    size_t allocsz = vsnprintf( NULL, 0, fmt, vp ) + 1;
    va_end( vp );

    va_copy( vp2, vp );
    char* buf = (char*)alloca( allocsz );
    vsprintf( buf, fmt, vp2 );
    va_end( vp2 );

    API_SendHostString( buf, allocsz );
}

extern "C" int API_Log( char const* txt )
{
    API_SendHostString( txt, strlen( txt ) + 1 );
    return 0;
}

/////////////////////////////////////////////////////////////////////////////
// Utility defs
bool readHostConn( void* dst, size_t len )
{
    size_t numRetries = 5;
    for ( ; numRetries; ) {
        // Flush transmit data before try read
        flushTransmitData();

        auto result = td_read( gHostConnection, (char*)dst, len );

        // If there's nothing to read, sleep for 1 cycle
        if ( result == 0 ) {
            vTaskDelay( 1 );
            continue;
        }
        else if ( result < 0 ) {
            vTaskDelay( pdMS_TO_TICKS( 10 ) );
            --numRetries;
        }

        len -= result;
        dst = (char*)dst + result;

        if ( len == 0 ) {
            return true;
        }
    }
    return false;
}

/////////////////////////////////////////////////////////////////////////////
//

void stringCmdHandler( char* str, size_t len )
{
    // Append last byte as null ch
    str[len + 1] = '\0';

    // Make tokens from string ... Maximum token = 16
    char* argv[16];
    int   argc = stringToTokens( str, argv, sizeof( argv ) / sizeof( *argv ) );

    if ( argc == 0 )
        return;

#define STRCASE( v ) upp::hash::fnv1a_32_const( v )

    switch ( upp::hash::fnv1a_32( argv[0] ) ) {
    case STRCASE( "env-report" ): {
    } break;

    case STRCASE( "test-timer" ): {
        static struct TI {
            uint64_t init;
            int      cnt = 0;
            int      num = 0;
            int      delay;
        } ti;
        int num = 1, delay = 1;

        if ( argc >= 2 )
            num = std::min( NUM_MAX_HWTIMER_NODE, std::max( 1, atoi( argv[1] ) ) );
        if ( argc >= 3 )
            delay = std::max( 100, atoi( argv[2] ) );

        if ( ti.cnt != ti.num ) {
            API_Log( "Yet timer task is running ... \n" );
            break;
        }
        ti.init  = API_GetTime_us();
        ti.cnt   = 0;
        ti.num   = num;
        ti.delay = delay;

        auto timer_cb = []( void* beg ) {
            auto&    t       = *(TI*)beg;
            uint64_t init    = t.init;
            uint64_t now     = API_GetTime_us();
            int      elapsed = now - init;

            API_Logf(
                "[%3d] %llu: %d us (error %d us)\n",
                t.cnt,
                now,
                elapsed,
                elapsed - ( t.delay * ( t.cnt + 1 ) ) );

            t.cnt++;
        };

        for ( int i = 0; i < num; i++ ) {
            auto correct_delay = delay * ( i + 1 ) - ( API_GetTime_us() - ti.init );
            API_SetTimer( correct_delay, &ti, timer_cb );
        }

    } break;

    case STRCASE( "test-input" ): {
        API_Logf( "Hello, world!\n" );
    } break;

    case STRCASE( "ping" ): {
        API_SendHostBinary( "ping", 4 );
    } break;

    default:
        if ( AppHandler_CaptureCommand( argc, argv ) )
            break;
        break;
    }
}

extern "C" __weak_symbol bool
AppHandler_CaptureCommand( int argc, char* argv[] )
{
    API_Logf( "info: Receiving :: " );
    for ( int i = 0; i < argc; i++ ) {
        API_Logf( "%s ", argv[i] );
    }
    API_Log( "\n" );
    return true;
}

extern "C" __weak_symbol bool
AppHandler_CaptureBinary( char* data, size_t len )
{
    return false;
}

void binaryCmdHandler( char* data, size_t len )
{
    if ( AppHandler_CaptureBinary( data, len ) ) {
        return;
    }

    API_Log( "warning: failed to process binary data\n" );
}

int stringToTokens( char* str, char* argv[], size_t argv_len )
{
    // Consume all initial spaces
    while ( *str == ' ' )
        ++str;

    // Ignore space-only string.
    if ( *str == 0 )
        return 0;

    int   num_token = 0;
    char* head      = str;

    for ( ; num_token < (int)argv_len; ) {
        if ( *head != ' ' && *head != '\0' ) {
            ++head;
            continue;
        }

        argv[num_token++] = str;
        if ( *head == 0 )
            break;

        for ( *head = 0; *++head == ' '; ) { }

        if ( *head == 0 )
            break;

        str = head; // Non-space character pos
    }

    return num_token;
}

void apndToHostBuf( void const* d, size_t len )
{
    uassert( s_hostTrBufHead + len < sizeof( s_hostTrBuf ) );

    while ( s_bFlushing )
        vTaskDelay( 1 );

    ++s_writingTask;
    s_hostTrBufHead += len;
    memcpy( s_hostTrBuf + s_hostTrBufHead - len, d, len );
    --s_writingTask;
}

void flushTransmitData()
{
    if ( s_hostTrBufHead == 0 )
        return;

    // Wait for all async write process done
    while ( s_writingTask > 0 )
        taskYIELD();

    s_bFlushing = true;
    td_write( gHostConnection, s_hostTrBuf, s_hostTrBufHead );
    s_hostTrBufHead = 0;
    s_bFlushing     = false;
}
