kang-sw-archive/depth-cam-adv/projects/depscan-firmware-rtos/Src-Usr/app.h

#pragma once
#include <FreeRTOS.h>

#include <stdbool.h>
#include <task.h>
#include <uEmbedded/transceiver.h>
#include "platform/mem.h"
#include "defs.h"
#ifdef __cplusplus
extern "C" {
#endif // __cplusplus

/////////////////////////////////////////////////////////////////////////////

/////////////////////////////////////////////////////////////////////////////

/////////////////////////////////////////////////////////////////////////////
// APIs

// Default functionality
// File xfer funtions
void API_SendHostBinary( void const* data, size_t len );
void API_SendHostString( void const* data, size_t len );
// This function does not enwraps data with header.
void API_SendHostRaw( void const* data, size_t len );

void API_Logf( char const* fmt, ... ); //!< Print text out to host.
int  API_Log( char const* txt );

// Timer functionality
usec_t         API_GetTime_us();
timer_handle_t API_SetTimer( usec_t delay, void* obj, void ( *cb )( void* ) );
timer_handle_t API_SetTimerFromISR( usec_t delay, void* obj, void ( *cb )( void* ) );
void           API_AbortTimer( timer_handle_t h );
bool           API_CheckTimer( timer_handle_t h, usec_t* usLeft );

/////////////////////////////////////////////////////////////////////////////
// Procedures
_Noreturn void AppProc_HostIO( void* nouse_ );
bool           AppHandler_CaptureCommand( int argc, char* argv[] );
bool           AppHandler_CaptureBinary( char* data, size_t len );

#ifdef __cplusplus
}
#endif // __cplusplus
