kang-sw-archive/depth-cam-adv/projects/depscan-firmware-rtos/Src-Usr/platform/hw.h

#pragma once
#include <stdbool.h>
#include <stdint.h>

#ifdef __cplusplus
extern "C" {
#endif // __cplusplus

/////////////////////////////////////////////////////////////////////////////
// Defs

/////////////////////////////////////////////////////////////////////////////
// Funcs
bool HW_CheckUsbConnection();
void InitHW();

// Inits
void HW_TIMER_INIT();
#ifdef __cplusplus
}
#endif // __cplusplus
