kang-sw-archive/depth-cam-adv/(commit log)

2020-01-22 Add new docs/refs
    [RPi-SODIMM-LNK.sch, RPiCML_IF.kicad_pcb, RPiCML_IF.sch]
2020-01-23 Improve clock configuration for STM32F4 board
    + Clock speed has increased to 84MHz, which is maximum.
2020-01-24 Configure debug process for vs
    Required programsf for vs debug:
    - Embedded arm dev sdk for vs
    - arm-none-eabi-gnu
    - openocd
    - netcat
    And these files should be established.
    - task.vs.json --> build, clean
    - launch.vs.json --> debugserver is ".launch.bat"
    - CppProperties.json
2020-01-27 Regenerate msp
    + SPI
    + GPIOs
2020-01-27 Regenerate code to resolve hard fault error
    [depscan-firmware-rtos.ioc]
2020-01-27 Resolve Hard fault error
    - EXTI IRQ1 is disabled. Seems not correctly configured.
    - Default task will sustain forever. Taskexit() from default task causes
    trouble.
    [app.cpp, depscan-firmware-rtos.ioc, hw.c, hw.h, main.h]
2020-01-28 Implement command procedure frame
2020-01-28 Implement host transfer frame
2020-01-28 Verify Host IO operation
    + Add command-line procedure for scangui
    - Fix invalid string token parser operation
    [app-proc.cpp, app.cpp, app.h, console-app.cpp, protocol.h, scanner_protocol_handler.cpp]
2020-01-30 Implement HW timer logic
2020-01-30 Verify hardware timer
2020-01-30 Improve timer
2020-01-31 Improve timer operation
2020-01-31 Veryfied synchronous SPI operation
    - However, for asynchronous SPI data transfer using a DMA controller,
    the read buffer is pulled by one byte.
2020-01-31 Discard asynchronous SPI using DMA
    - The 'Byte Shift' problem, which occurs when using the DMA feature, has
    not been fixed. It has been reported from several communities that this
    is a hardware defect, so the inherent resolution seems difficult. In
    case of using synchronous SPI, it works without any defect, so it is not
    a big problem.
    [depscan-firmware-rtos.ioc, s2pi.c]
2020-01-31 Add motor interface functions
2020-02-01 Create interface for sensor and motor
2020-02-01 Create distance sensor impl file
2020-02-01 Implement sensor handling functionalities
2020-02-01 Implement distance sensor condition checker
    + Block configuration during capture
2020-02-01 [wip] Fix error on timer logic
    [app-conn.cpp, app-test.cpp, app.cpp, hwtim.cpp, s2pi-irq.c, s2pi.c]
2020-02-01 [wip] Still stick with hard-fault ...
    - Seems error occurs when TransferFrame called
    thru IRQ callback, but hard to know exact error
    since there's no information about tasks.
    [app-conn.cpp, app-test.cpp, app.h, hwtim.cpp, s2pi-irq.c, s2pi.c]
2020-02-01 Fix hard fault error on measurement
    - The biggest cause of all errors came from ridiculous mistakes. No
    validation was done during the invoke of the measurement callback, which
    caused a segmentation fault.
    - Another error is due to the incomplete implementation of the vsnprintf
    function in the nano spec, which causes miscalculated characters to
    contaminate the stack, making it difficult to track.
    - Luckily for now, I've solved the urgent error to get the measurement
    data, but currently the uEmbedded library's fslist is not implemented
    correctly, so I'm using STL's list for timer implementation. You should
    fix the malfunction of the fslist and optimize the behavior of the
    SetTimerFromIRQ func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
    [app-test.cpp, defs.h, dist-sensor.cpp]
2020-02-02 Fix timer fault
    - by resolving fslist's invalid operation ...
    ~ Update TODOs, BUGs
    [app-test.cpp, dist-sensor.cpp, hwtim.cpp, s2pi.c]
2020-02-02 Implement motor IRQ handler's outline
    + Lower down motor timer IRQ priority to 5 to use
    FreeRTOS APIs inside of motor ISR.
2020-02-02 Implement arch-independent logics to drive motor
    ~ Because this implementation takes full advantage of FPU, precise
    performance analysis must be preceded for any potential loss of
    performance.
2020-02-03 Implement motor driver's hardware side
2020-02-03 Add motor initialization code
    + Mandate argument error handling to each handler.
    [app-capture.cpp, app-conn.cpp, hw.c]
2020-02-03 Implement motor logical test
2020-02-03 Implement Depscan Interface Board
    [MEASURE_IF.sch]
2020-02-05 Implement IF board artwork:
    [MEASURE_IF.csv, MEASURE_IF.kicad_pcb, MEASURE_IF.sch]
2020-02-06 Fix pin location error
    [MEASURE_IF.kicad_pcb, MEASURE_IF.sch]
2020-02-07 Circuit minor update
2020-02-07 Connect NRST signal to motor driver
    [MEASURE_IF.kicad_pcb, MEASURE_IF.sch]
2020-02-07 Fix issue that acceleration value is not applied
    - Simply fixed by adjusting evaluation priority
    + Found ideal default accel/velocity value
    [motor.cpp]
2020-02-07 Make capturer instance be in sync with device
2020-02-07 Resolve c++17 compilation issue
    [hwtim.cpp]
2020-02-08 Resolve disconnection issue
    + Disconnection issue was resolved by deallocating com stream before
    open new com stream.
    + Now the connection process is more polished.
    [app.cpp, communication_handler.cpp, communication_handler.hpp, console-app.cpp, scanner_protocol_handler.cpp, scanner_protocol_handler.hpp, win32.cpp]
2020-02-08 [WIP] Add a watchdog timer to measurement
    + It is a timer instance that has a longer delay than measurement time.
    If the measurement succeeds before it triggers, it'll be aborted
    automatically. However when if it triggers, it is treated as an error
    that something is lost during measurement.
    [app-test.cpp, dist-sensor.cpp, dist-sensor.h, hwtim.cpp]
2020-02-08 [WIP] Handling error on async measurement
    [app-test.cpp]
2020-02-09 Set default configuration on sensor init proc
2020-02-09 Fix segfault on disconnection
    [console-app.cpp]
2020-02-09 Fix invalid watchdog timer trigger issue
    - The major issue was resolved by correcting timer logic's invalid
    find() operation
    [app-test.cpp, dist-sensor.cpp]
2020-02-10 Change measurement callback error handling method
    + Now non-zero evaluation result is not treated as error, but still
    should be treated carefully. Error code handling now will be mandated
    to the callee.
    [dist-sensor.cpp]
2020-02-10 Use returned measured data with non-zero error code
    [app-test.cpp]
2020-02-10 Refactor DistSens_MeasureSync
    + Now this function returns actual error code from ARGUS library
    [dist-sensor.cpp, dist-sensor.h]
2020-02-10 Suppress warnings by correcting them
    [hwtim.cpp, motor.cpp]
2020-02-10 Use correct return value to fit in type
    [dist-sensor.cpp]
2020-02-10 Deactivate motor debug trace sequence
2020-02-10 Implement scanning task
    + A scan job consists of a set of asynchronous jobs. To maintain the st
    ability of the device state, state changes such as stops and pauses are
    always performed when all asynchronous tasks have finished.
2020-02-11 Modify initial motor clock speed
2020-02-11 Re-factor motor position logics
    + Motor APIs to control motor position value is clarified.
    - Removed ResetPos
    [app-capture.cpp, app-test.cpp, motor.cpp, motor.h]
2020-02-11 Improve retry logic for scanning process
    + Now the device will reinitialize sensor for every measurement failure
    [app-capture.cpp]
2020-02-11 Invert X motor direction
    [motor.cpp]
2020-02-11 Fix incorrect parameter settings
    [gui-app.cpp, scanner_protocol_handler.cpp]
2020-02-11 Implement stop command
    + Now motor returns to its initial position when movement finished.
    + Now motor-move command does not change actual position
2020-02-11 Comment for a bug
    [motor.cpp]
2020-02-11 Update to new device commands
2020-02-11 Fix segfault on reconnect for GUI app
    [communication_handler.cpp]
2020-02-12 Add distance sensor test logic for console
2020-02-12 Fix invisible elapsed time
    [app-capture.cpp]
2020-02-13 Fix invalid connector boundary
    [MEASURE_IF.kicad_pcb]
2020-02-14 Fix motor position error
    + Error on motor position on fast motor movement was fixed by using
    timer PWM one pulse mode
    [depscan-firmware-rtos.ioc, motor.cpp]
2020-02-14 Implement point caputure mode
    + Point capture mode provides a simple measurement interface based on
    the index and absolute step position of the motor.
    Extract capture initiation logic into a function
    + A call to point-start is added.
    Implement enqueue logic for point mode
    Fix possible memory leak on dist-sensor API
    Implement Pop
    Resolve build error
    Fix program fault on repetitive sensor refresh
    - The issue was due to insufficient stack memory. It was resolved by
    extending stack depth into 512 words, from 256.
    Extract measurement functionality from capture
    Measurement functionalities are extracted into a helper function for
    later usage in point capture mode.
    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
    [app-capture.cpp, console-app.cpp, defs.h, dist-sensor.cpp, scanner_protocol.h, scanner_protocol_handler.cpp, scanner_protocol_handler.hpp]
2020-02-17 Change data communication method to ASCII
    + Originally data communication between the host and the device used
    specialized data descriptor with 4 bytes of size.
    However, this method prevents a user from using the device through a
    primitive terminal program. Instead, it forces us to use a special
    library that handles the protocol.
    Since the data transmission rate of the USB-FS interface is outstanding
    compared to other communication interfaces, I decided to represent
    binary data as readable characters; '1-9', 'a-f'. Despite doubling its
    data size.
    Thus, for now, a user can access the device's commands without any
    special library, only with the method to access the virtual COM port
    that is pr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
    [MEASURE_IF.sch]
2020-02-20 Port overall system to G431KB based board
    ~ VID, PID is changed to 0x6080, 0xccd2 respectedly
    - The build configuration for F401VC is now obsolete. Mamma mia!
    ---- PREVIOUS COMMITS ----
    Remove unused project directory
    - A separate project directory for G431KB is removed. From now on,
    both F401VC and G431KB projects will be managed at the same time and
    will have only minor differences in user code.
    Configure build environment for G431KB
    Configure build environment for G431KB
    [WIP] Handling USB initialization error ...
    [WIP]
    Configure USB communication
    Verify USB/Sensor operation
    Update .gitignore
    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
    [MEASURE_IF.sch]
2020-02-21 Make motor callback delay for 200us
    + Since finishing the PWM signal transfer does not mean the motor is
    actually stopped, 200 us of delay is added to the motor movement done
    callback call.
2020-02-24 Improve board artwork
    [MEASURE_IF.csv, MEASURE_IF.kicad_pcb, MEASURE_IF.sch]
2020-02-29 Improve outline of overall image processing
    + Improvement on device interface
    + New features with opencv manipulation
    + Improvement on scanlib APIs
    >>>>>> PRIVIOUS COMMITS
    [WIP] Resolving communication issue
    Implement center point calculation
    Improve debugging interface
    Resolve USB transfer error :
    -- PREVIOUS COMMIT HEADERS --
    [WIP] Adapting new argus API ...
    [wip] Add stack overflow hook
    Set default adapter speed
    Resolve error superficially
    + Interrupt during xfer was allowed. Now transfer sequence only blocks scheduling.
    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
    [app-capture.cpp, app-conn.cpp, app.cpp, app.h, argus_api.h, argus_dca.h]
2020-02-29 Fix exception on CreateFile
    [app.cpp]
2020-03-01 Add samples
2020-03-01 Fix fatal error on device disconnection
    [scanner_protocol_handler.cpp]
2020-03-01 Apply bilateral filter
2020-03-01 Treat stalled data as non-error data
    [dist-sensor.cpp]
2020-04-01 Generate few more samples
2020-04-01 Save filtered depth image as result
2020-04-01 Save both of filtered and raw image
2020-04-02 Fix incorrect camera initialization
    [entry.cpp]
2020-04-14 Apply tangential distortion calibration
