kang-sw-archive/depth-cam-adv/(notices)

Notices in the files:
projects/depscan-firmware-rtos/Inc/main.h:
© Copyright (c) 2020 STMicroelectronics.
All rights reserved.
This software component is licensed by ST under Ultimate Liberty license
(C) COPYRIGHT STMicroelectronics *****END OF FILE
schematics/MEASURE_IF/MEASURE_IF.sch:
Copyright 2020. Seungwoo Kang. All rights reserved
